arjun2000ananth/SAR_ADC_IHP/README.md

# 10-Bit SAR ADC — IHP SG13CMOS5L

A fully differential 10-bit successive-approximation-register (SAR) ADC designed in the **IHP SG13CMOS5L** process for the **Chipalooza Challenge**.

The repository contains the transistor-level analog design, SAR control logic, block-level and top-level layout, post-layout verification, and the integration into **Chipalooza slot 16**.

The ADC targets approximately **1 MS/s** operation and uses separate **3.3 V analog/high-voltage** and **1.2 V digital/low-voltage** supply domains.

ADC block and slot-level sign-off have passed. Result plots are available in [`docs/`](docs/).

---

## Team

| Name | Role |
|---|---|
| Arjun Ananth | Lead Designer - Design & Layout |
| Man Yu | Verification |

---

## Overview

The ADC uses a fully differential charge-redistribution SAR architecture.

Main blocks:

- Differential input sampling network
- Fully differential 10-bit capacitive DAC
- Strong-arm dynamic comparator with latch
- 1.2 V ↔ 3.3 V level shifters
- SAR finite-state machine
- Digital conversion outputs and status signals

Block diagram:

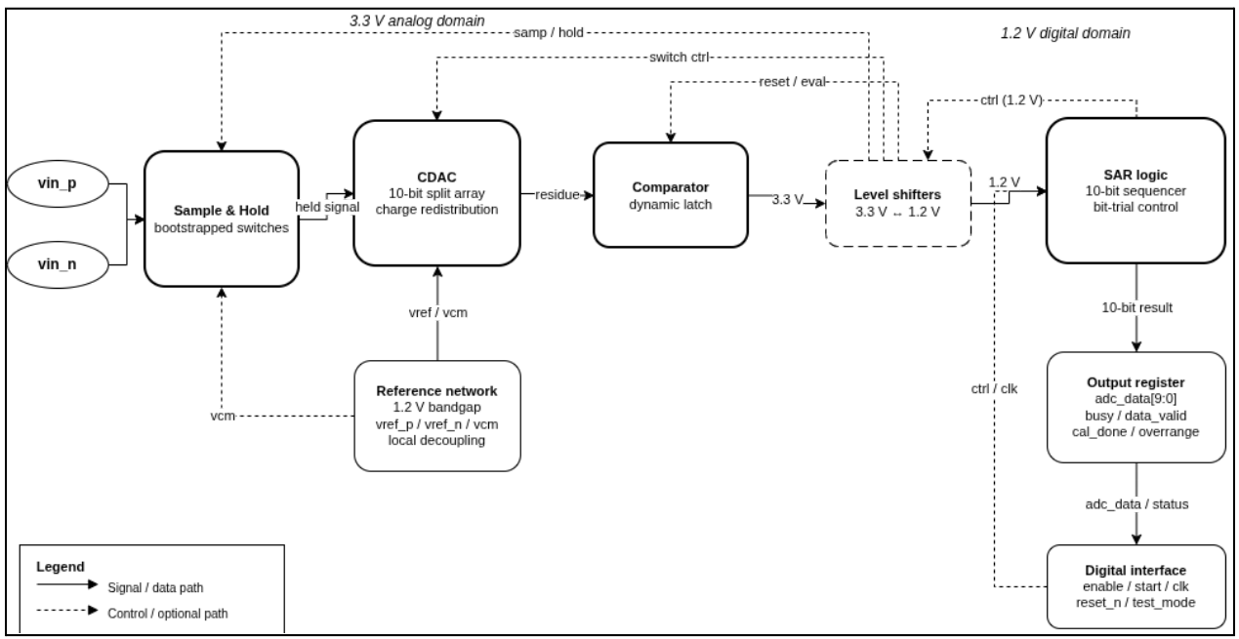
[picture p1: docs/Block_Diagram.png]
Block Diagram


---

## Architecture

The ADC consists of the following main blocks:

### Sampling Network

The differential input is sampled onto the CDAC before the SAR conversion begins.

### Capacitive DAC

A fully differential 10-bit capacitive DAC performs the successive-approximation charge redistribution. The CDAC uses a common-mode based differential switching scheme and is implemented using SG13CMOS5L MOM capacitors.

### Comparator

A strong-arm dynamic comparator performs the bit decisions during conversion.

### Level Shifters

The analog circuitry operates primarily from the 3.3 V domain while the SAR controller operates at 1.2 V. Level shifters provide the required voltage-domain crossings between the digital controller and the analog switching circuitry.

### SAR Controller

The SAR controller is implemented as a synthesized FSM operating in the 1.2 V domain.

It controls:

- Sampling
- Comparator timing
- CDAC bit decisions
- Conversion sequencing
- `busy`
- `valid`
- Final 10-bit output code

---

## Conversion Sequence

A conversion proceeds as follows:

1. The differential input is sampled onto the CDAC.
2. The sampling switches open.
3. The SAR controller applies the MSB trial decision.
4. The comparator resolves the differential DAC residue.
5. The decision is stored.
6. Steps 3–5 repeat for the remaining bits.
7. The final 10-bit result is presented on `C[9:0]`.
8. `valid` is asserted when the result is available.

`busy` indicates that a conversion is currently in progress.

At a 60 MHz conversion clock, the controller completes one conversion every 60 cycles (1 MS/s) in the functional simulation.

---

## Supply Domains

| Domain | Nominal Voltage | Usage |
|---|---:|---|
| `vddh` | 3.3 V | Analog / hv circuitry |
| `vddl` | 1.2 V | SAR FSM and lv digital circuitry |
| `vss` | 0 V | Common ground |

The nominal CDAC reference (`vrefp`) is 3.3 V, with `vcm` at 1.65 V. Both references are routed through shared analog buses in the harness.

---

## SAR ADC Interface

The reusable `sar_10_bit` ADC macro has the following interface.

### Analog and Supply Pins

| Signal | Direction | Description |
|---|---|---|
| `ainp` | Input | Positive differential analog input |
| `ainn` | Input | Negative differential analog input |
| `vrefp` | Input | CDAC reference voltage |
| `vcm` | Input | Common-mode voltage |
| `Voutn` | Output | Comparator/debug analog output |
| `vddh` | Supply | 3.3 V supply |
| `vddl` | Supply | 1.2 V supply |
| `vss` | Supply | Ground |

### Digital Control Pins

| Signal | Direction | Description |
|---|---|---|
| `CLK` | Input | SAR conversion clock |
| `START` | Input | Starts a conversion |
| `RSTN` | Input | Active-low reset |

### Digital Outputs

| Signal | Direction | Description |
|---|---|---|
| `C0`–`C9` | Output | 10-bit conversion result |
| `busy` | Output | Conversion in progress |
| `valid` | Output | Conversion result valid |

---

# Chipalooza Integration

This project is assigned to **slot 16** of the IHP SG13CMOS5L Chipalooza test chip. The reusable ADC and the Chipalooza implementation are kept separate.

The harness integration expects its slot GDS at:

```text
final/gds/slot_16.gds
```

The `sar_10_bit` cell remains the reusable ADC macro and can be integrated independently into other designs.

---

## Slot-16 Signal Mapping

### Analog Inputs and References

| Chipalooza Signal | ADC Signal | Function |
|---|---|---|
| `s16_an[0]` | `ainp` | Positive differential input |
| `s16_an[1]` | `ainn` | Negative differential input |
| `analog_bus0` | `vrefp` | ADC reference voltage |
| `analog_bus1` | `vcm` | ADC common-mode voltage |

### Supplies

| Chipalooza Signal | ADC Signal |
|---|---|
| `vdd_3v3` | `vddh` |
| `vdd_1v2` | `vddl` |
| Ground network | `vss` |

### Control

| Chipalooza Signal | ADC Signal |
|---|---|
| `clk` | `CLK` |
| `dig_in[0]` | `START` |
| `dig_in[1]` | `RSTN` |

### Digital Outputs

| ADC Signal | Chipalooza Signal |
|---|---|
| `C0` | `dig_out[0]` |
| `C1` | `dig_out[1]` |
| `C2` | `dig_out[2]` |
| `C3` | `dig_out[3]` |
| `C4` | `dig_out[4]` |
| `C5` | `dig_out[5]` |
| `C6` | `dig_out[6]` |
| `C7` | `dig_out[7]` |
| `C8` | `dig_out[8]` |
| `C9` | `dig_out[9]` |
| `busy` | `dig_out[10]` |
| `valid` | `dig_out[11]` |

The harness routes START and RSTN through a digital input latch. A sustained START level produces repeated conversions; a short single-shot START pulse can be supplied through an external GPIO route or an appropriately configured sequencer.

---

# Layout

The reusable top-level ADC GDS is located at:

```text
circuit_files/layout/top/sar_10_bit_top.gds
```

The pre-fill version is retained at:

```text
circuit_files/layout/top_prefill/sar_10_bit_top_prefill.gds
```

Individual block layouts are available under:

```text
circuit_files/layout/
```

Layout views and characterization result plots are available in [`docs/`](docs/).

---

# SAR FSM

The SAR controller RTL is located at:

```text
circuit_files/src/sar_fsm/sar_fsm.v
```

---

# Target Performance

| Parameter | Target | Status |
|---|---:|---|
| Resolution | 10 bits | 10 bits |
| Architecture | Fully differential SAR | Fully differential SAR |
| Sampling rate | 1 MS/s | 1 MS/s in harness functional simulation at 60 MHz |
| Analog supply | 3.3 V | 3.3 V nominal |
| Digital supply | 1.2 V | 1.2 V nominal |
| DNL | Within ±1 LSB | Peak absolute DNL 0.199 LSB |
| INL | Within ±1 LSB | Peak absolute INL 0.139 LSB |
| Missing codes | None | None |
| Input type | Differential | Differential |
| Digital result | 10-bit parallel code | `C[9:0]` |
| Status outputs | `busy`, `valid` | Verified in sim |

The latest characterization plots are in [`docs/`](docs/).

The analysis also reported a 57.2 mV peak VSS IR drop, a 1.75 Ω VCM switch-tap resistance, and a 4.23 fF differential top-plate parasitic-capacitance difference.

---

# Results and Figures

The plots, schematics, and layout views below are stored in [`docs/`](docs/) and displayed directly from those files. 

## ADC Layout

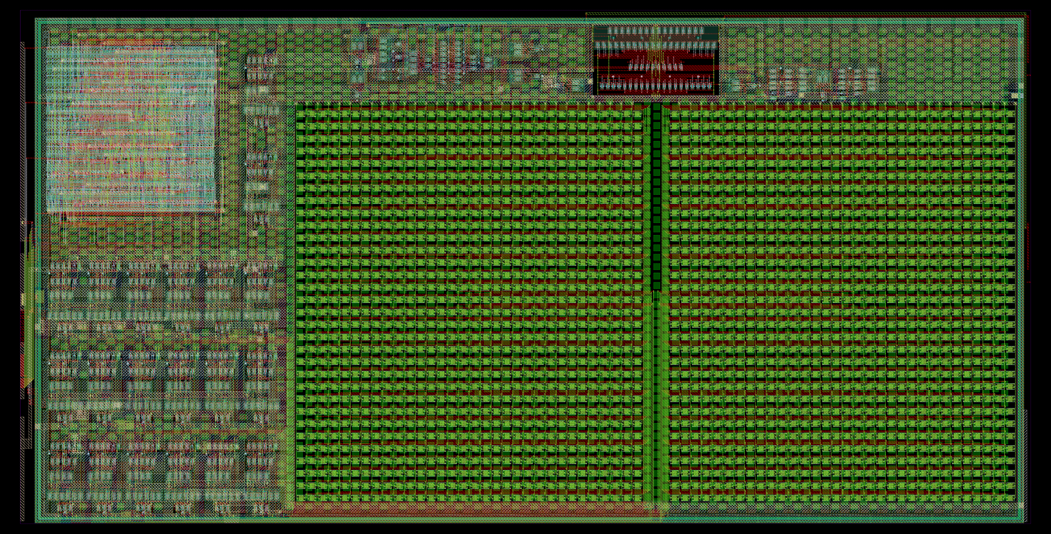
[picture p2: docs/layouts/sar_top_gds.png]
Complete SAR ADC GDS layout


*Top-level `sar_10_bit` layout.*

## Static Linearity and Transfer Characteristic

| | |
|:---:|:---:|
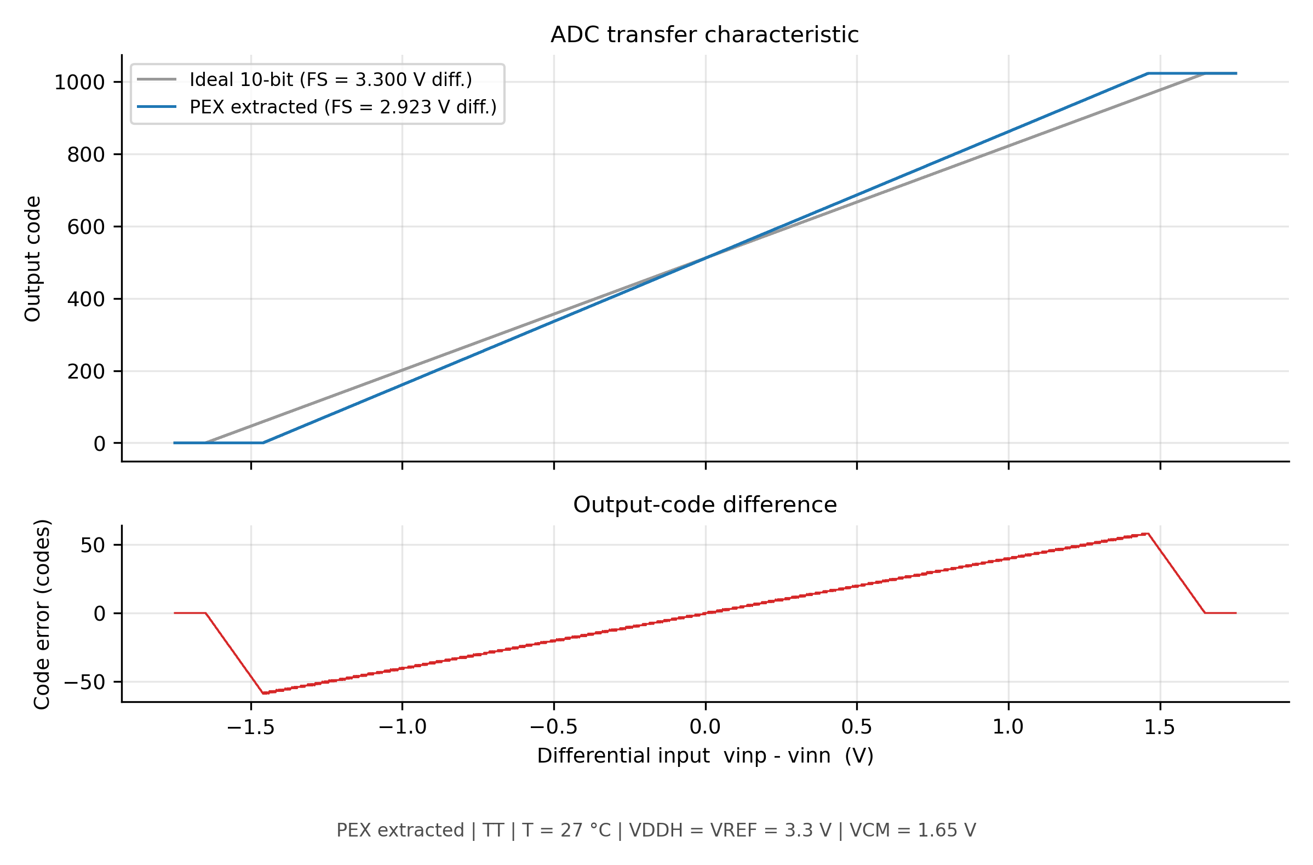
[picture p3: docs/transfer_characteristic.png]
ADC transfer characteristic
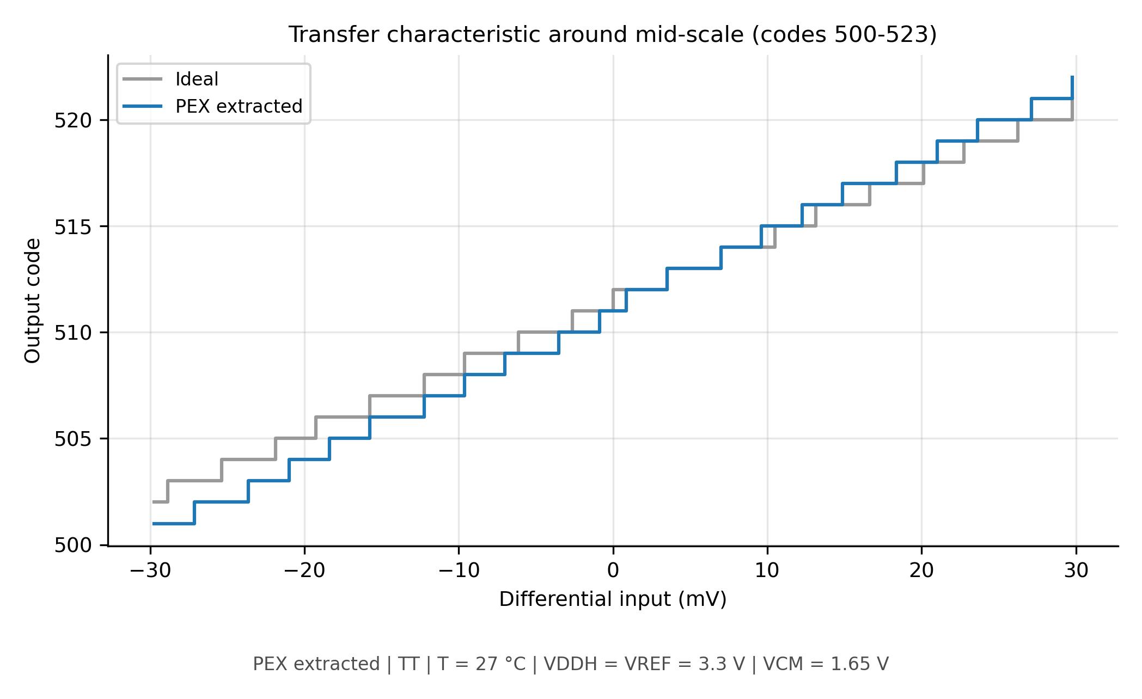
[picture p4: docs/transfer_midscale_zoom.png]
Transfer characteristic near midscale
| <br><sub>ADC transfer characteristic</sub> | <br><sub>Transfer characteristic near midscale</sub> |
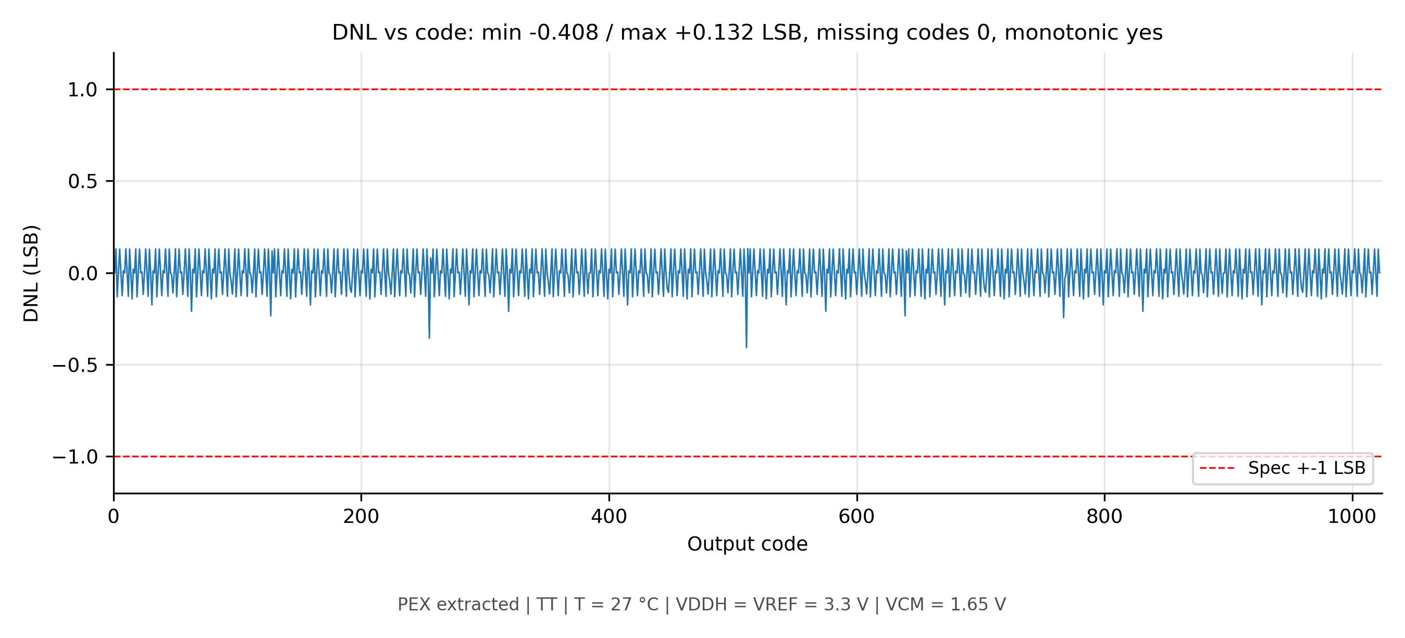
[picture p5: docs/dnl_vs_code.png]
DNL versus output code
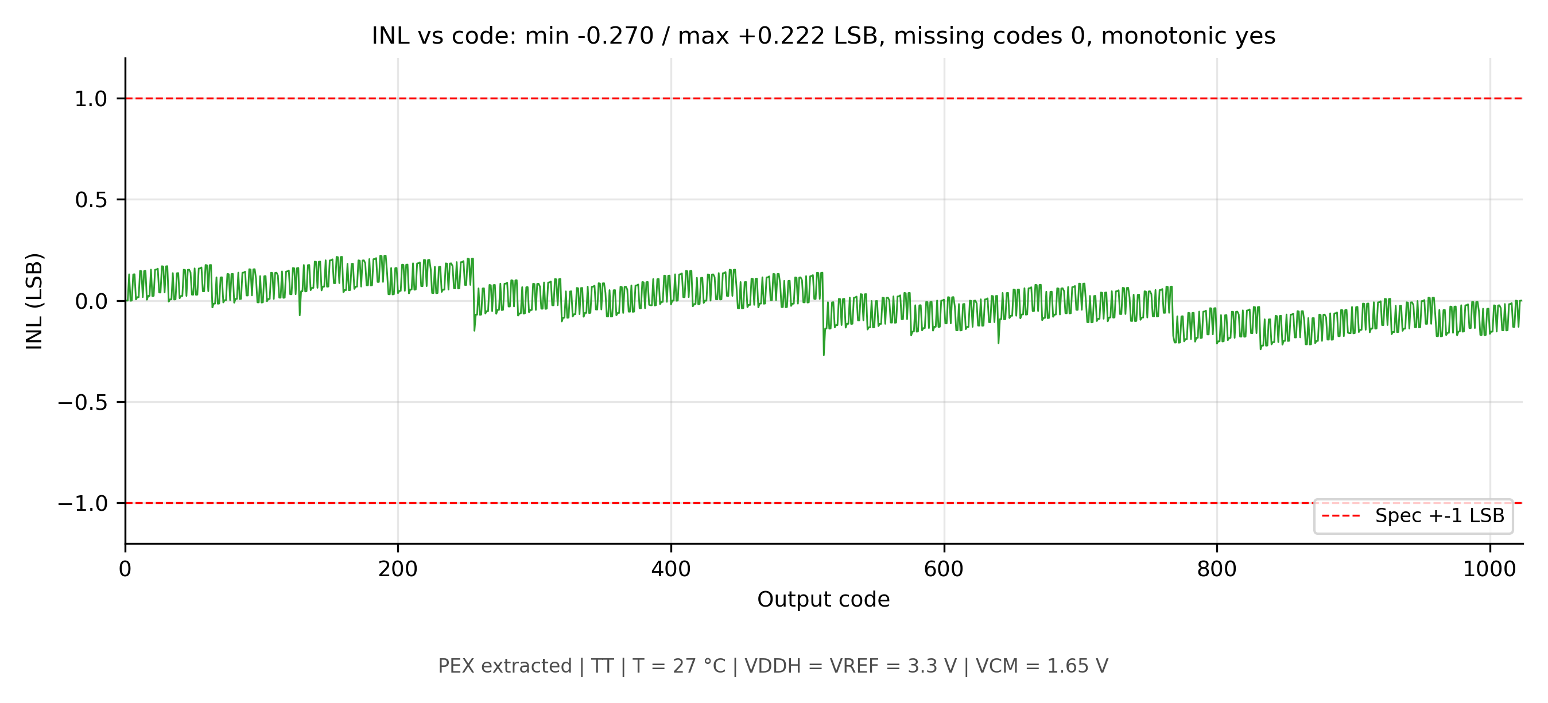
[picture p6: docs/inl_vs_code.png]
INL versus output code
| <br><sub>DNL versus output code</sub> | <br><sub>INL versus output code</sub> |
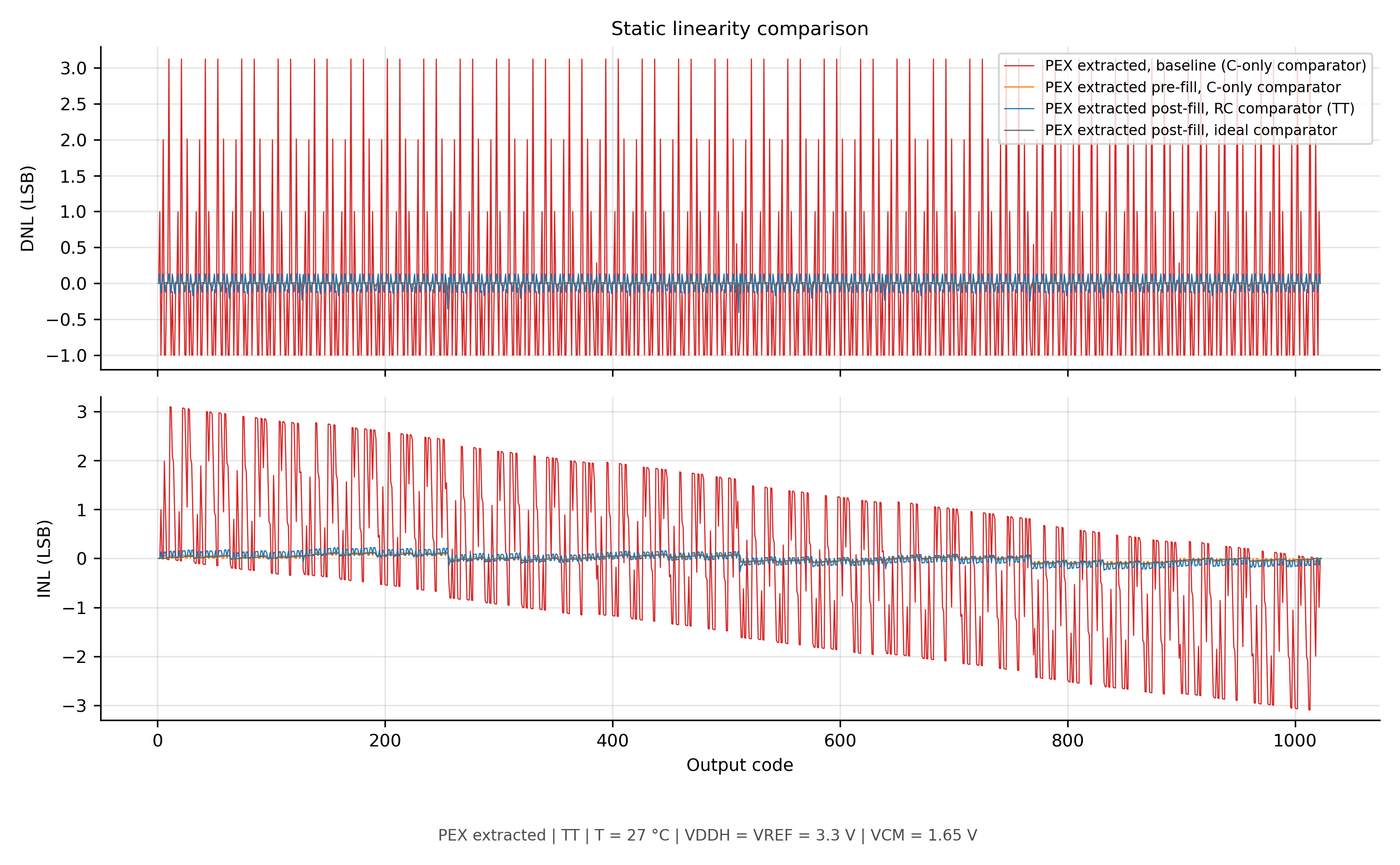
[picture p7: docs/dnl_inl_pex_comparison.png]
PEX linearity comparison
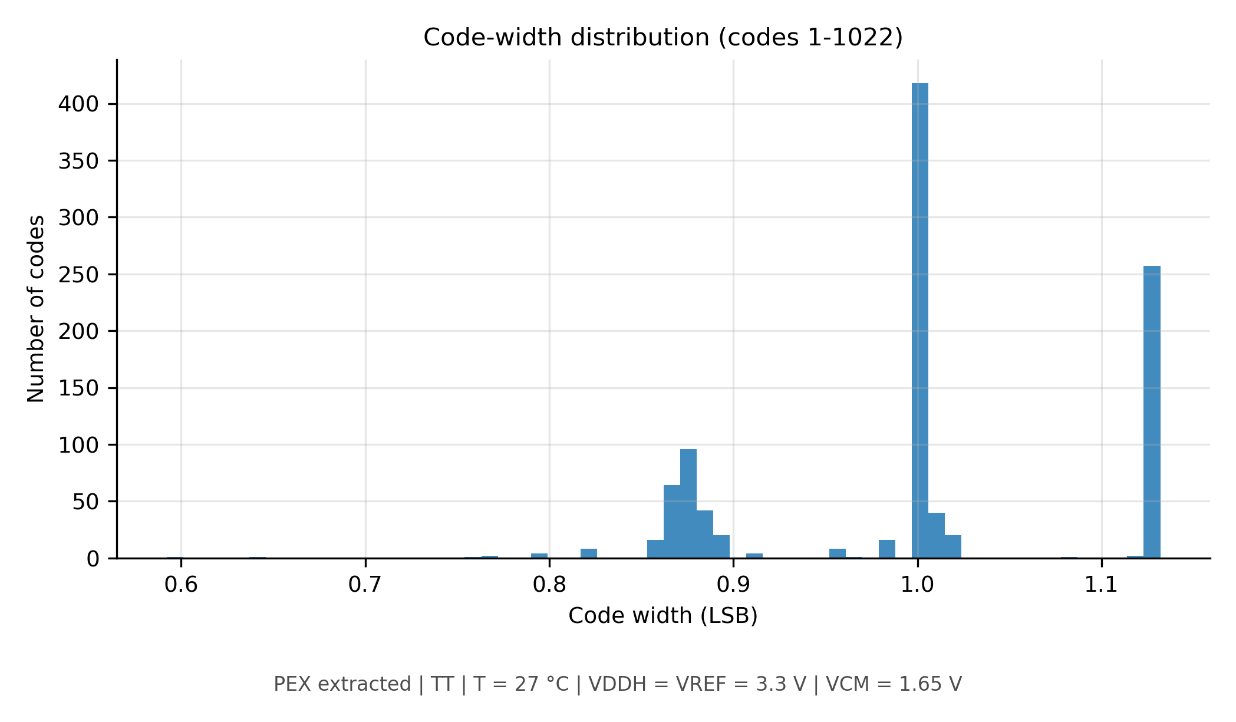
[picture p8: docs/code_width_histogram.png]
Code width histogram
| <br><sub>PEX linearity comparison</sub> | <br><sub>Code width histogram</sub> |

## Conversion Timing, Dynamic Performance and Power

| | |
|:---:|:---:|
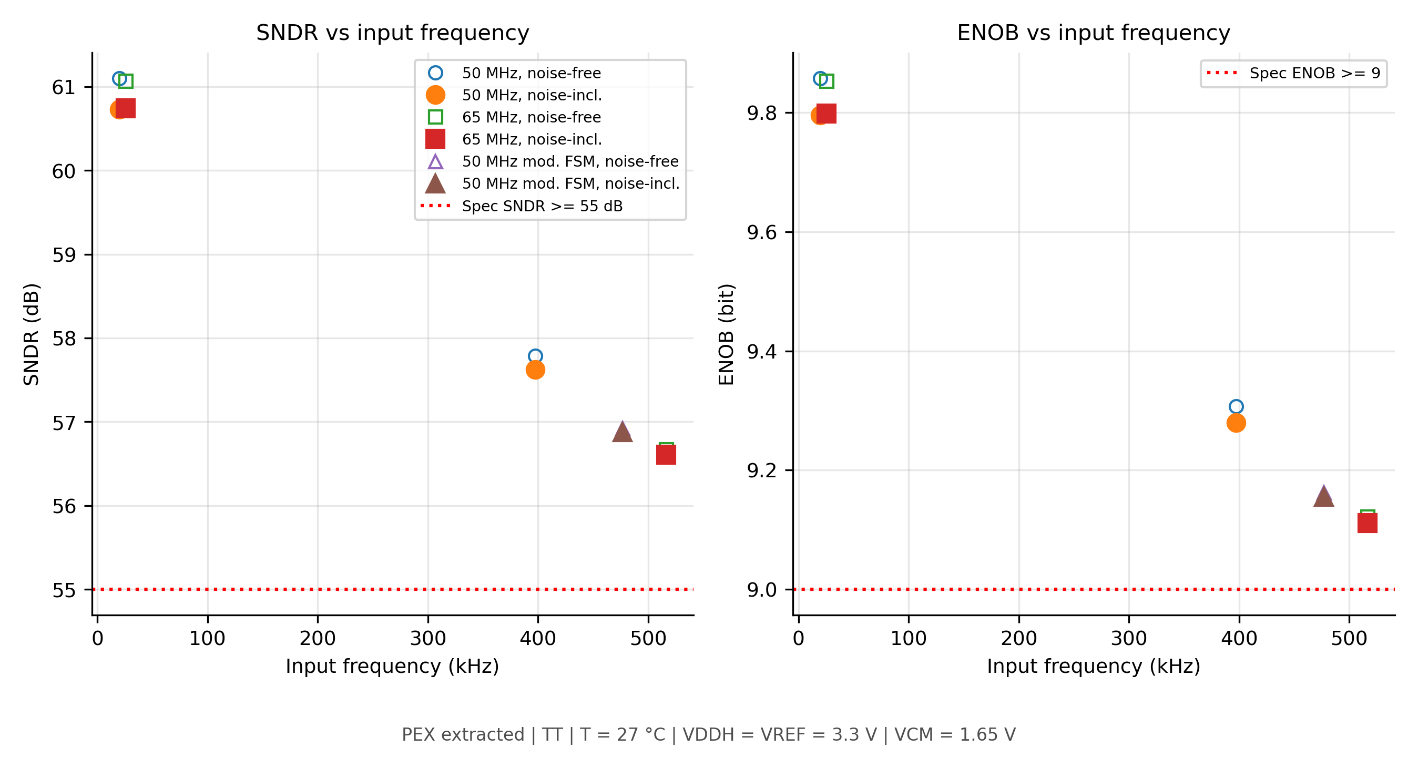
[picture p9: docs/sndr_enob_vs_fin.png]
SNDR and ENOB versus input frequency
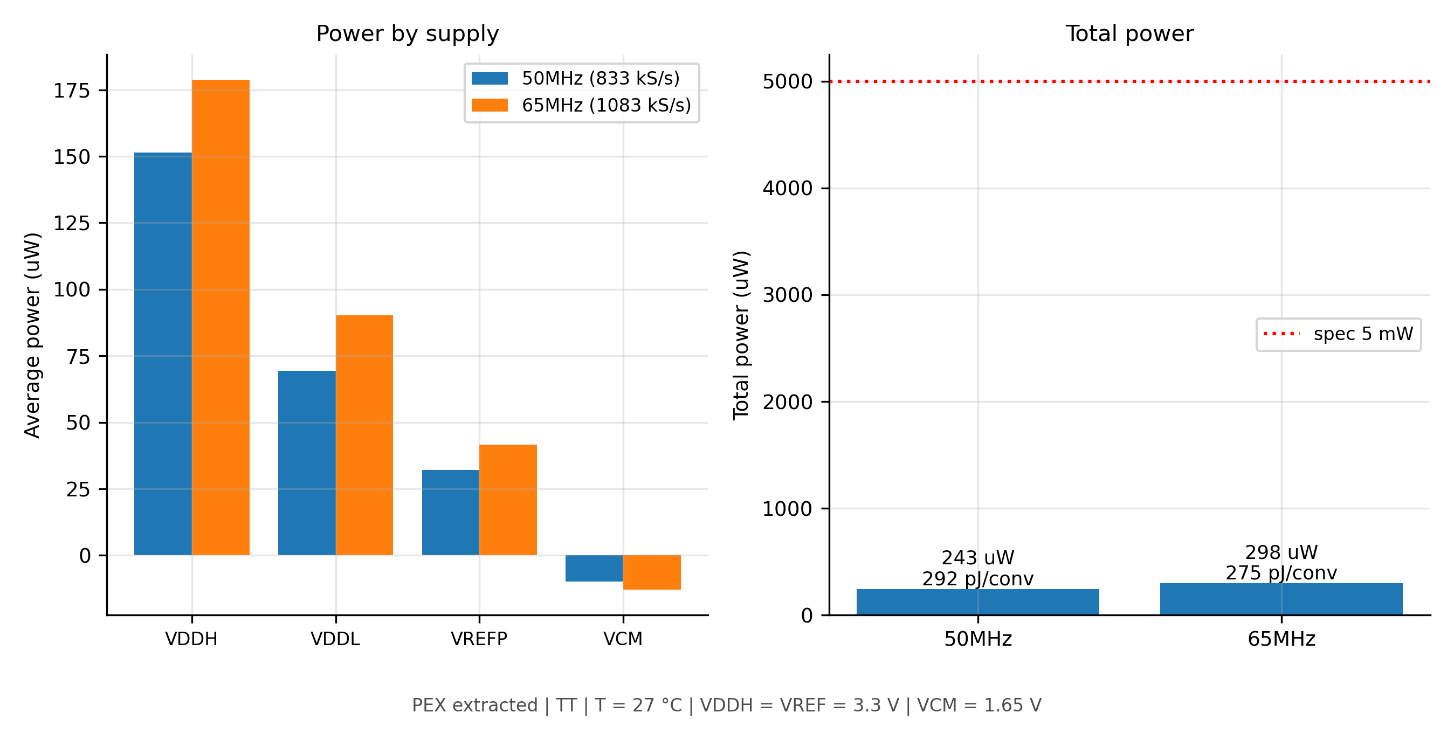
[picture p10: docs/power_50_vs_65MHz.png]
Power at 50 and 65 MHz
| <br><sub>SNDR and ENOB versus input frequency</sub> | <br><sub>Power at 50 and 65 MHz</sub> |
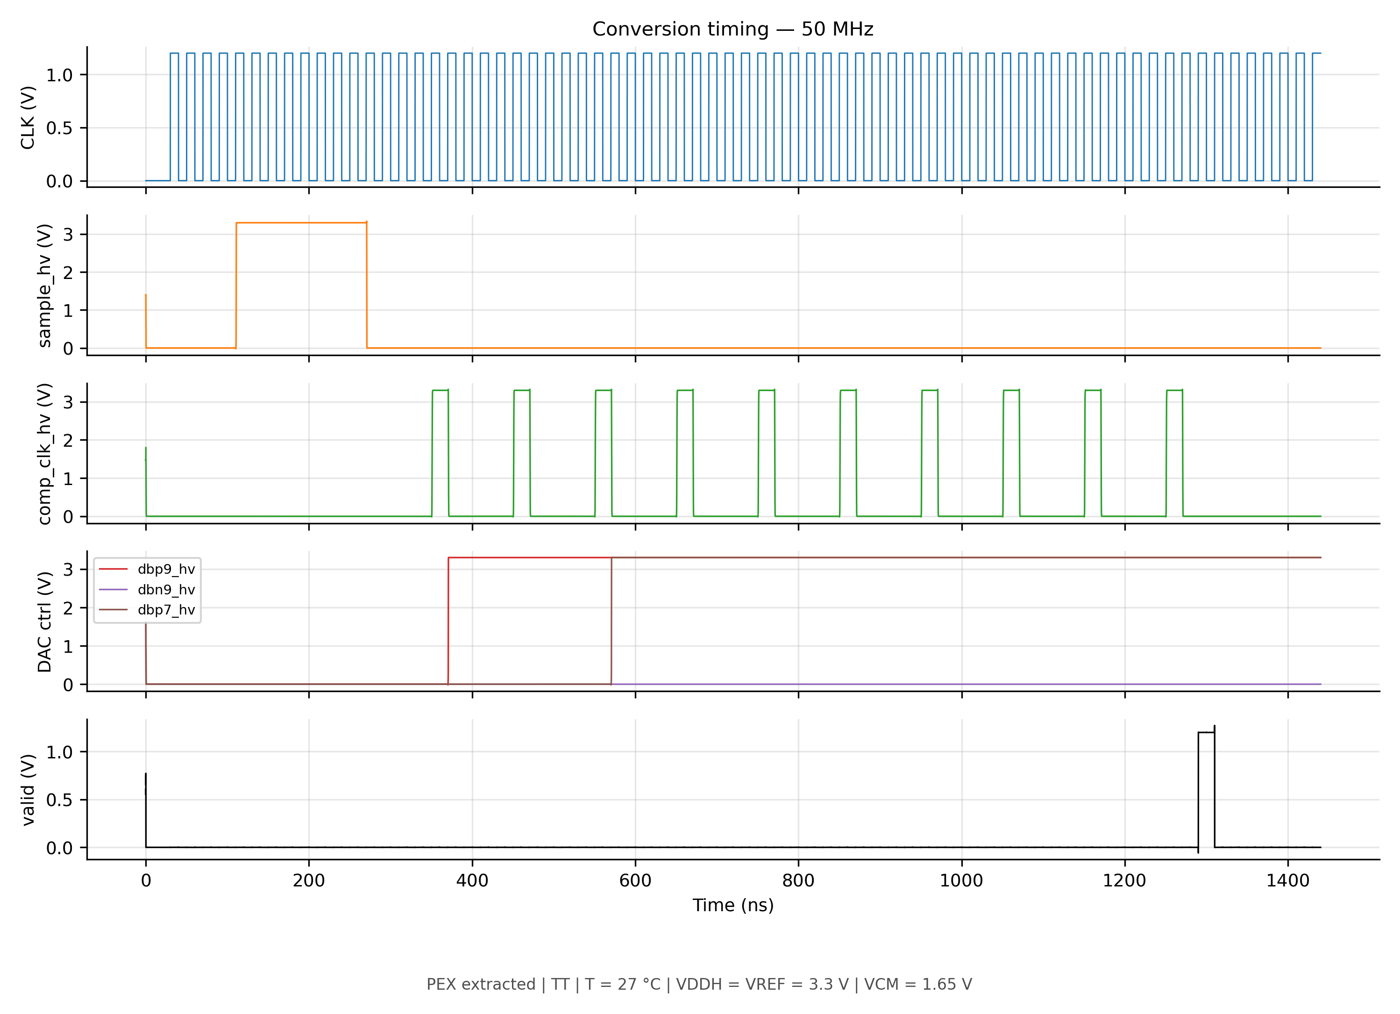
[picture p11: docs/conversion_timing_50MHz.png]
Conversion timing at 50 MHz
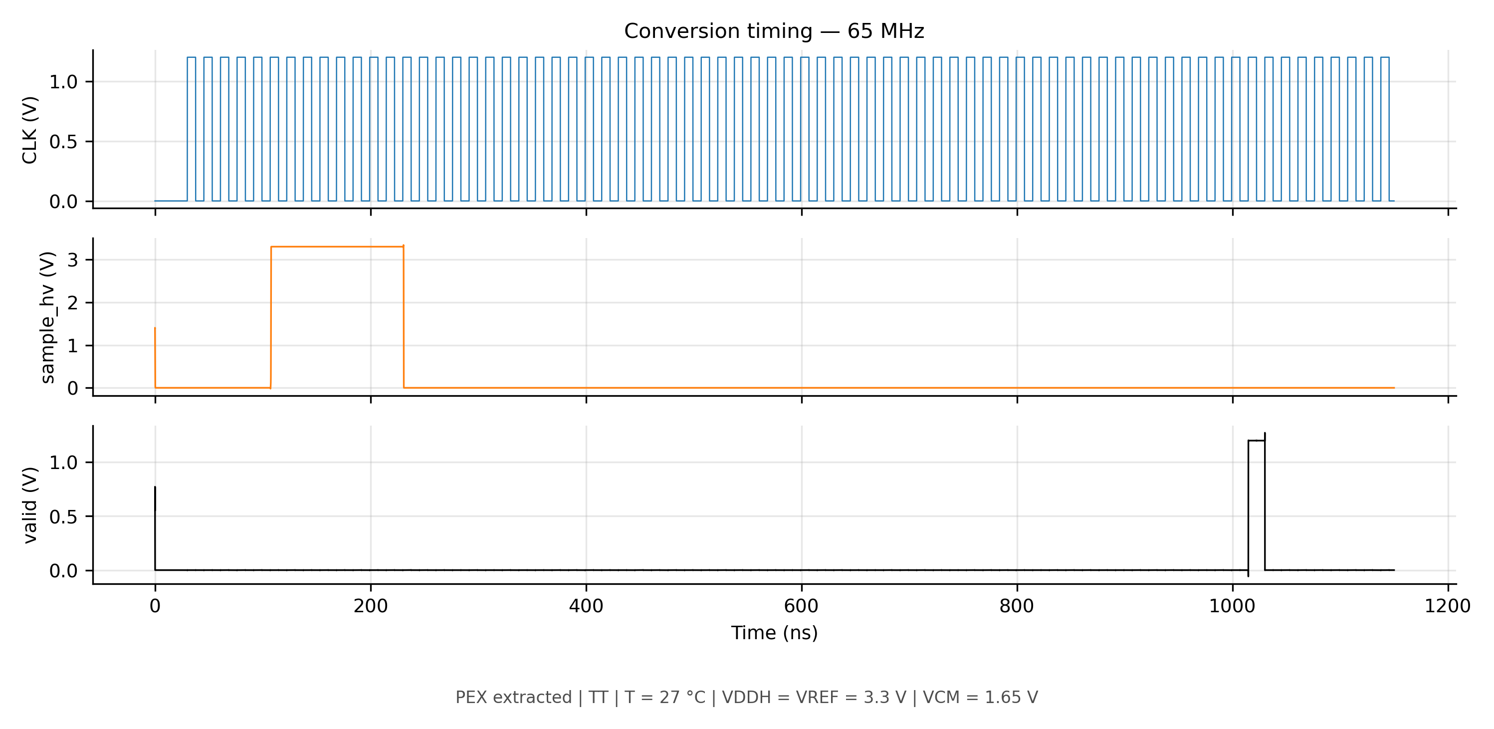
[picture p12: docs/conversion_timing_65MHz.png]
Conversion timing at 65 MHz
| <br><sub>Conversion timing at 50 MHz</sub> | <br><sub>Conversion timing at 65 MHz</sub> |
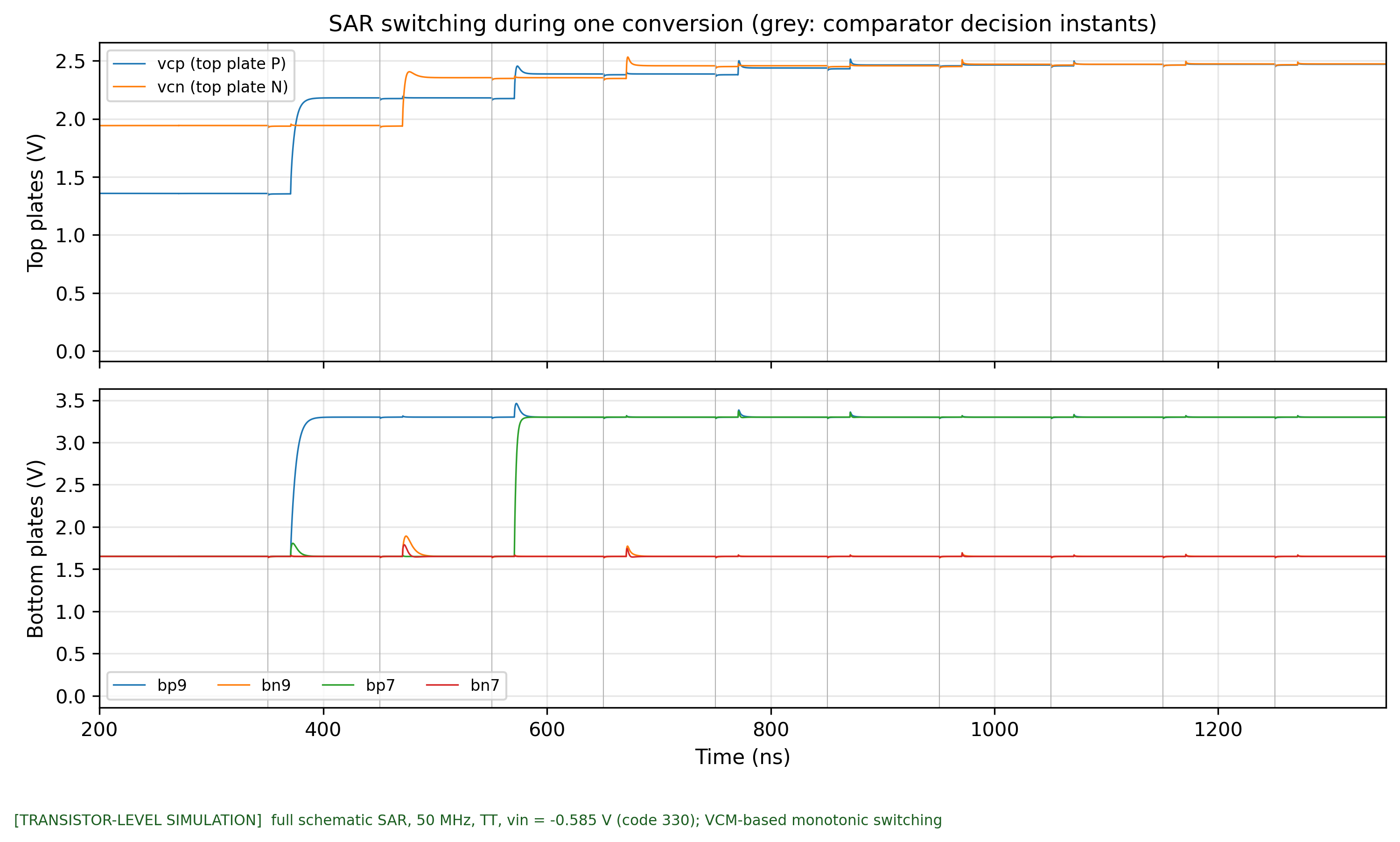
[picture p13: docs/sar_switching_waveforms.png]
SAR switching waveforms
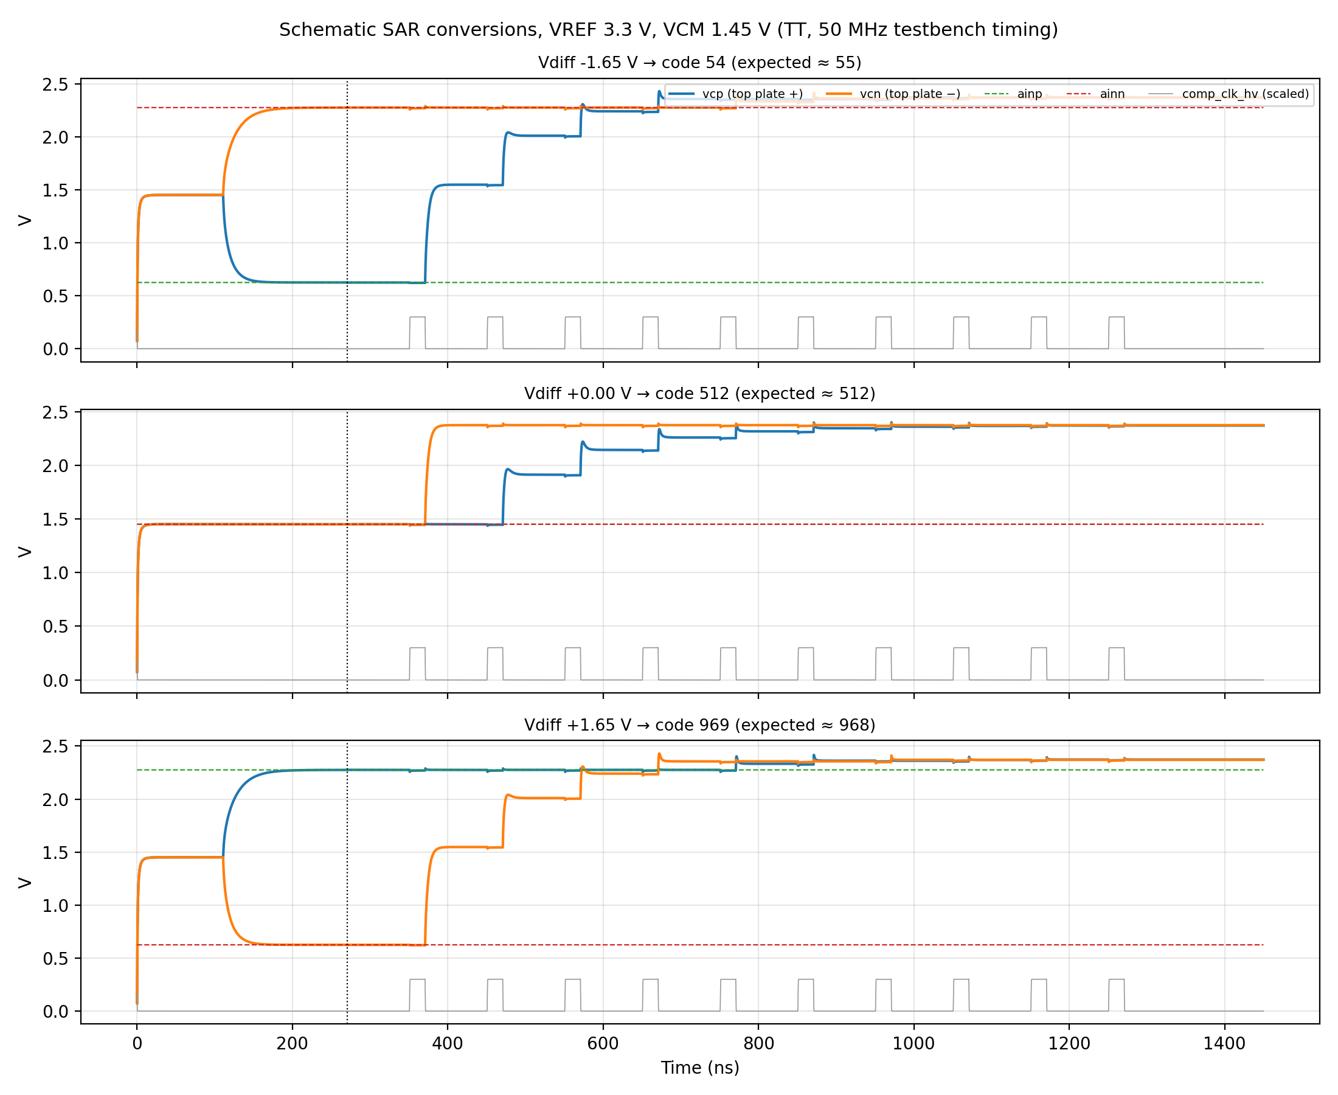
[picture p14: docs/smoke_vcm1.45_waveforms.png]
Transient smoke test with VCM at 1.45 V
| <br><sub>SAR switching waveforms</sub> | <br><sub>Transient smoke test with VCM at 1.45 V</sub> |

## CDAC Settling

| | |
|:---:|:---:|
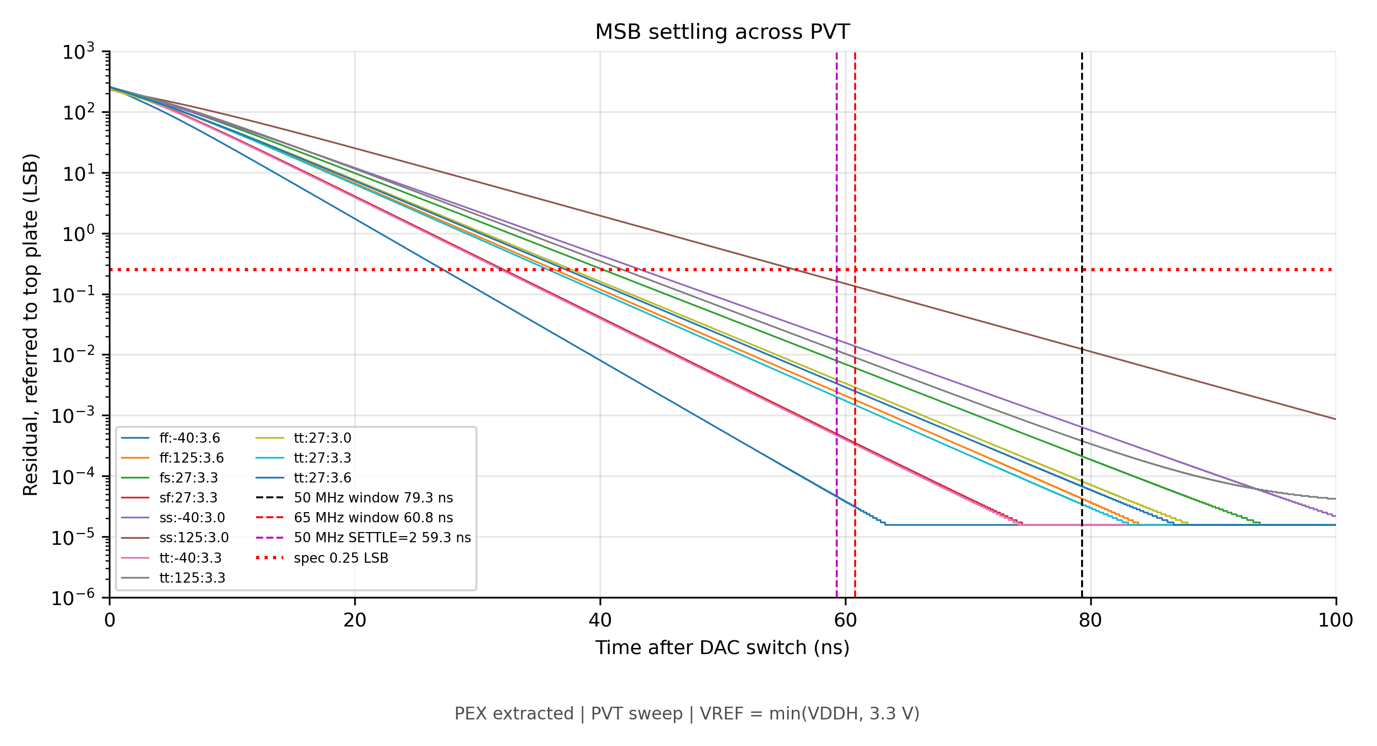
[picture p15: docs/cdac_settling/msb_settling_pvt.png]
MSB settling across PVT conditions
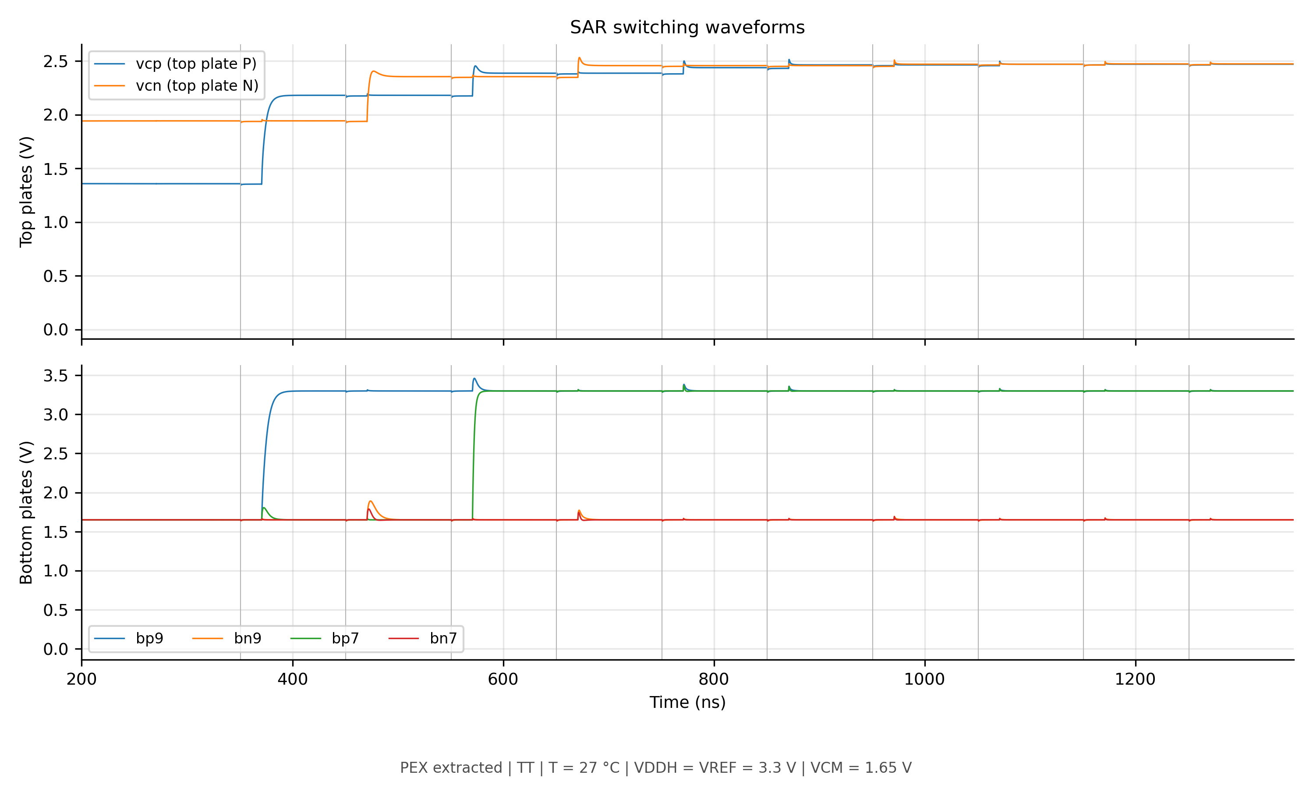
[picture p16: docs/cdac_settling/sar_switching_waveforms.png]
CDAC switching waveforms
| <br><sub>MSB settling across PVT conditions</sub> | <br><sub>CDAC switching waveforms</sub> |

## Comparator Characterization

| | |
|:---:|:---:|
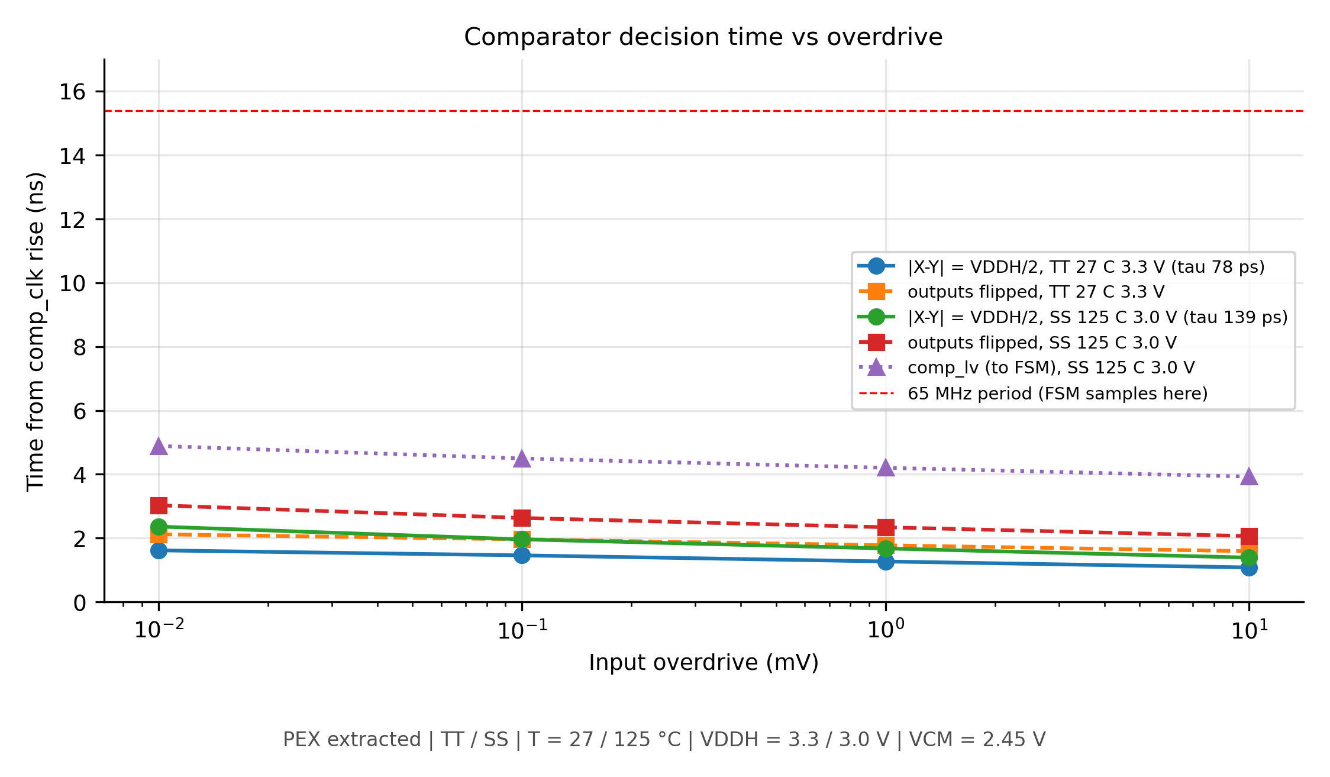
[picture p17: docs/comparator/decision_time_vs_overdrive.png]
Comparator decision time versus overdrive
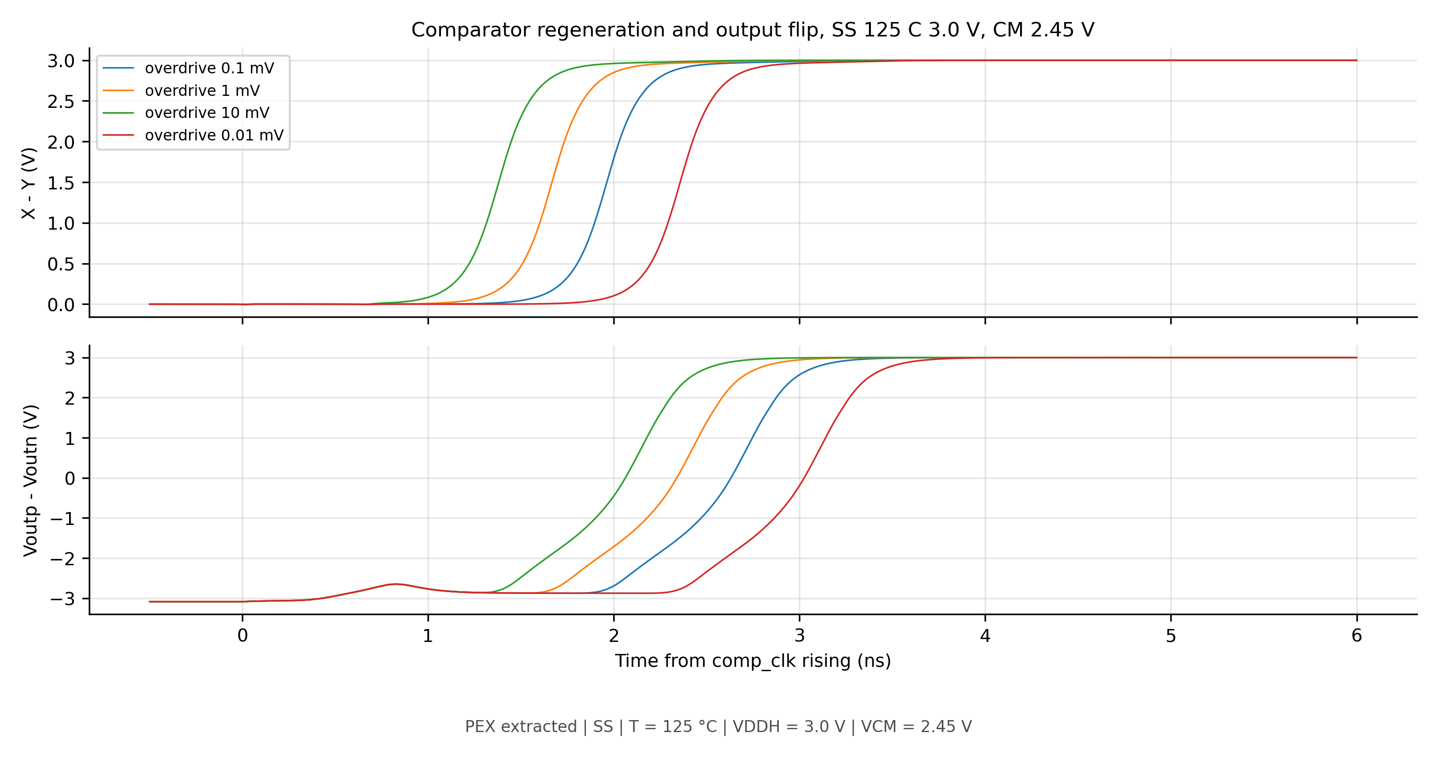
[picture p18: docs/comparator/decision_waveforms_ss_125_3.png]
Comparator waveforms, SS at 125 C
| <br><sub>Comparator decision time versus overdrive</sub> | <br><sub>Comparator waveforms, SS at 125 C</sub> |
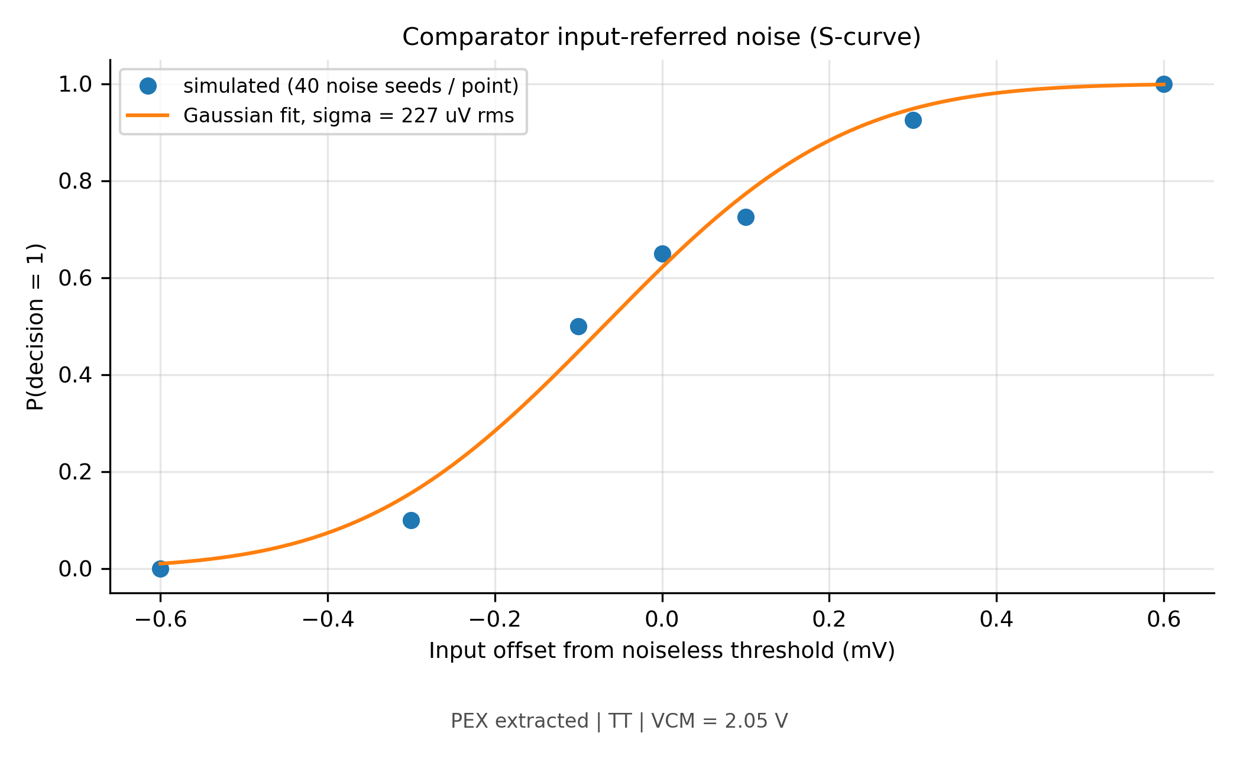
[picture p19: docs/comparator/noise_scurve.png]
Comparator noise S-curve
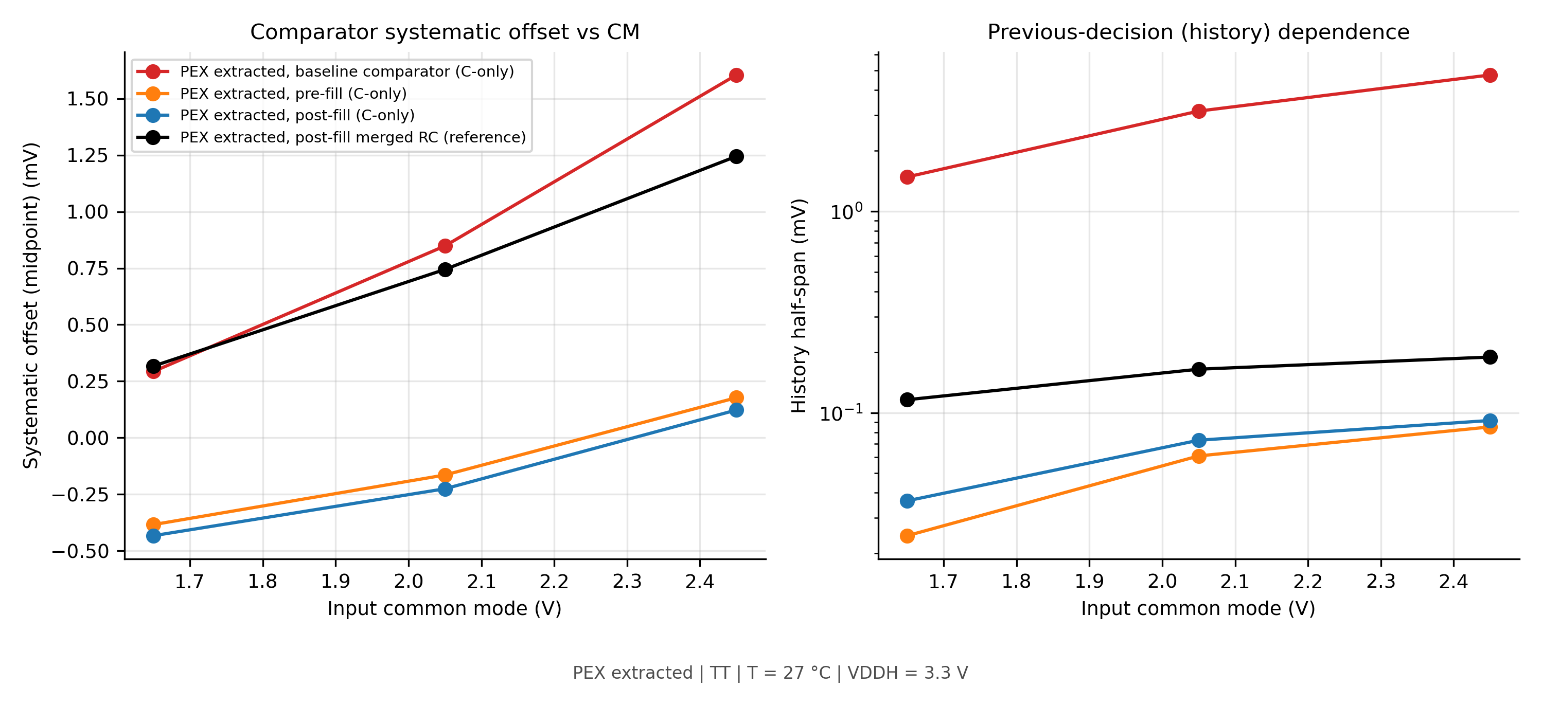
[picture p20: docs/comparator/offset_history_vs_cm.png]
Comparator offset history versus common-mode
| <br><sub>Comparator noise S-curve</sub> | <br><sub>Comparator offset history versus common-mode</sub> |

## PVT and Monte Carlo Analysis

| | |
|:---:|:---:|
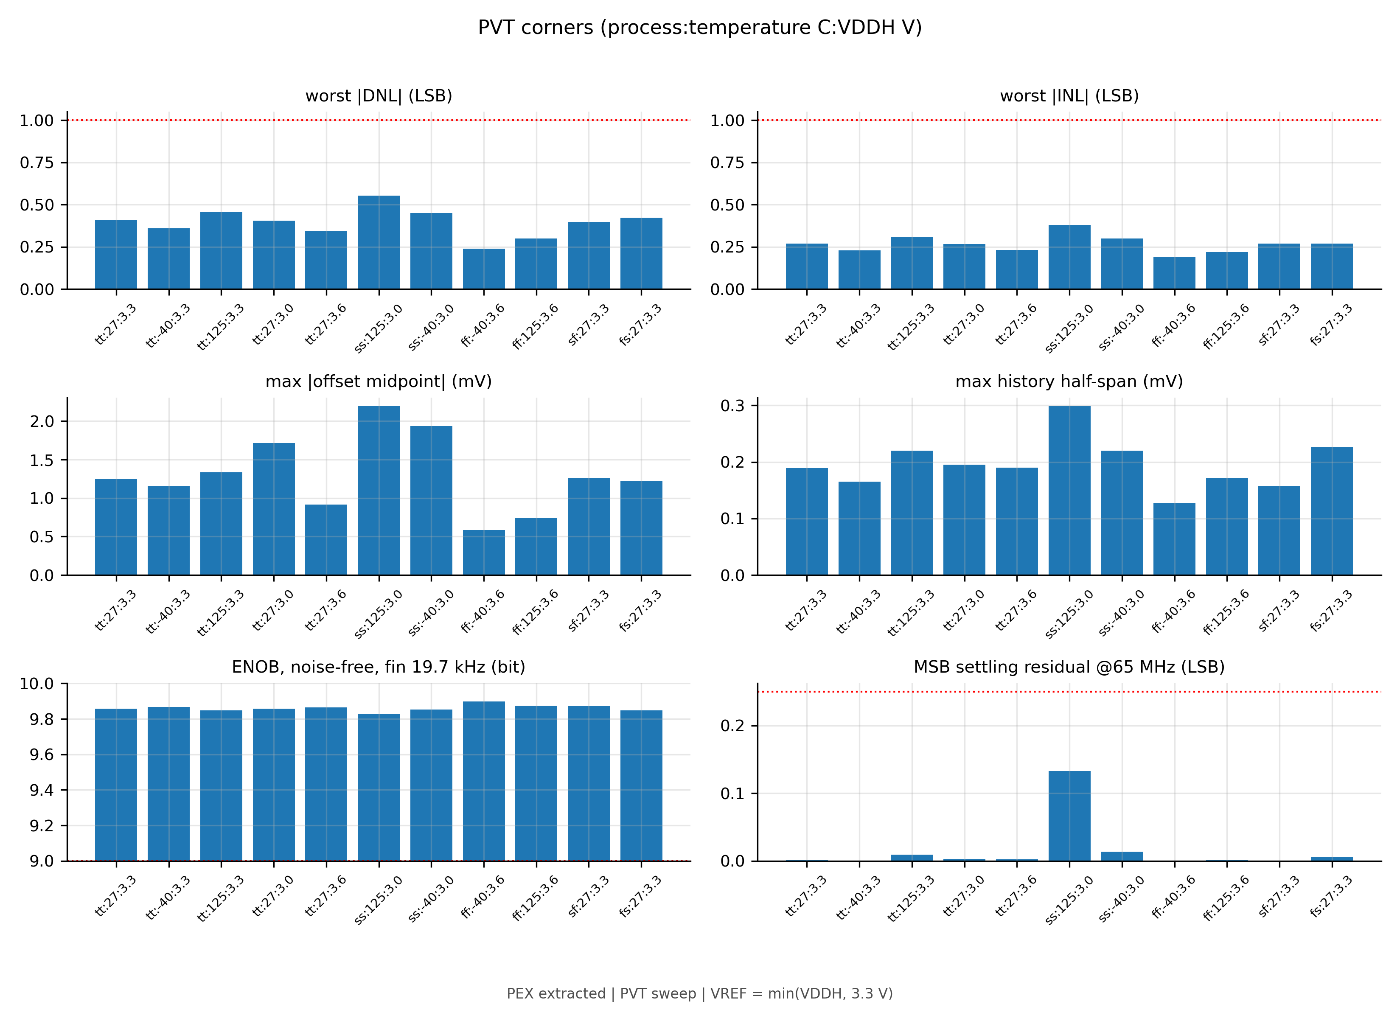
[picture p21: docs/corner/pvt_summary.png]
PVT corner summary
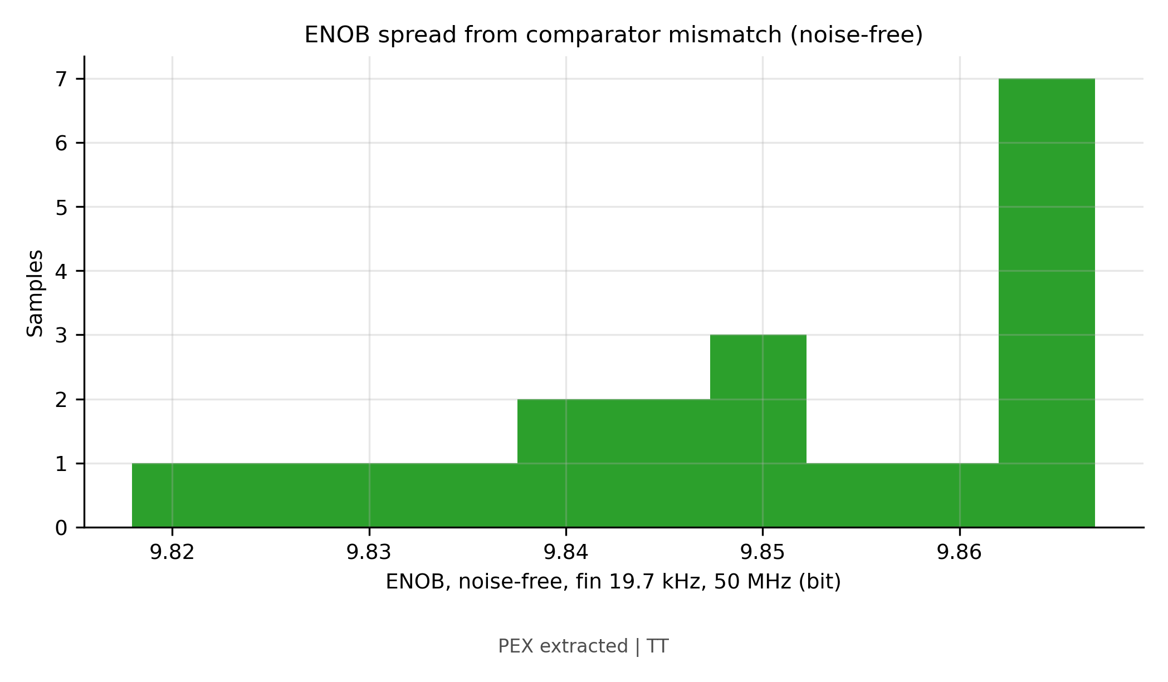
[picture p22: docs/montecarlo/enob_distribution.png]
Monte Carlo ENOB distribution
| <br><sub>PVT corner summary</sub> | <br><sub>Monte Carlo ENOB distribution</sub> |
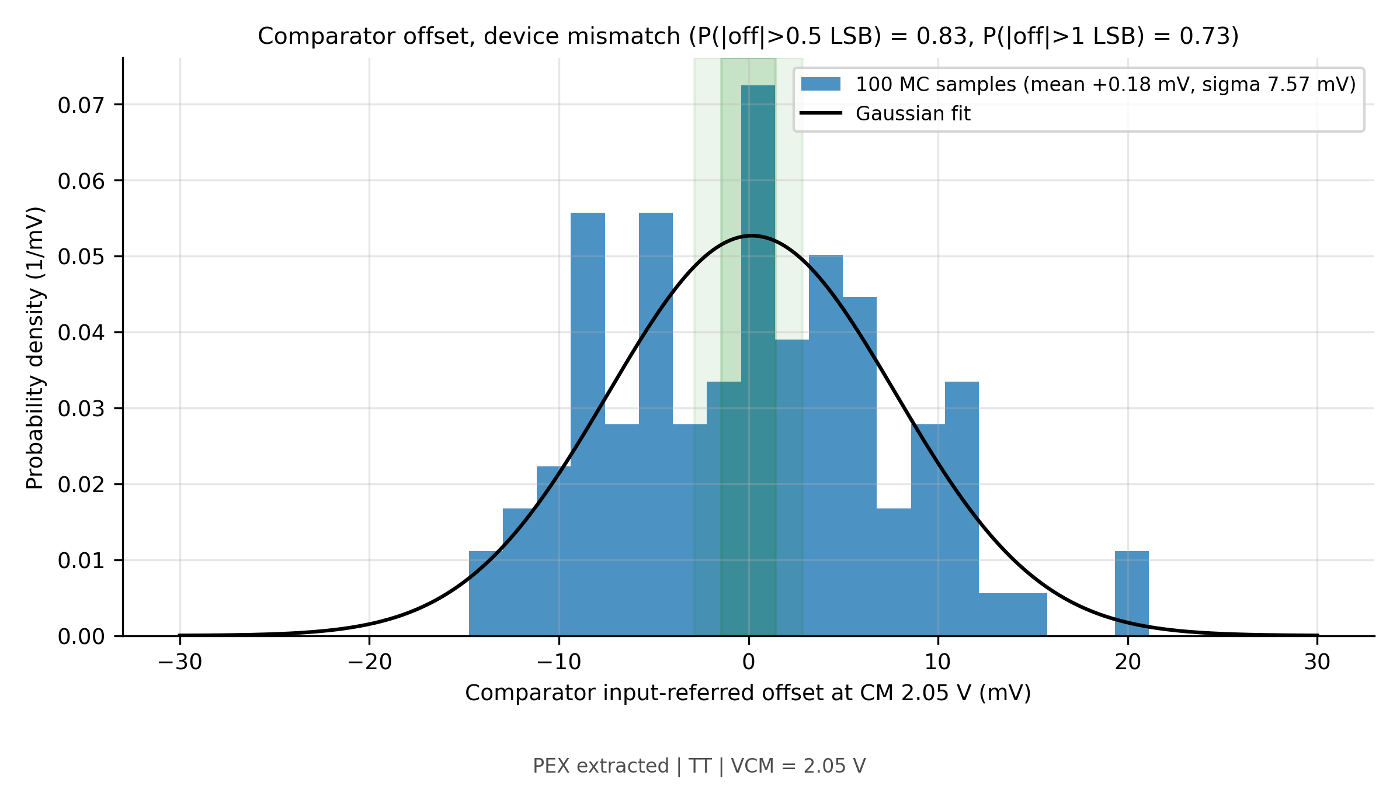
[picture p23: docs/montecarlo/offset_histogram.png]
Monte Carlo comparator offset histogram
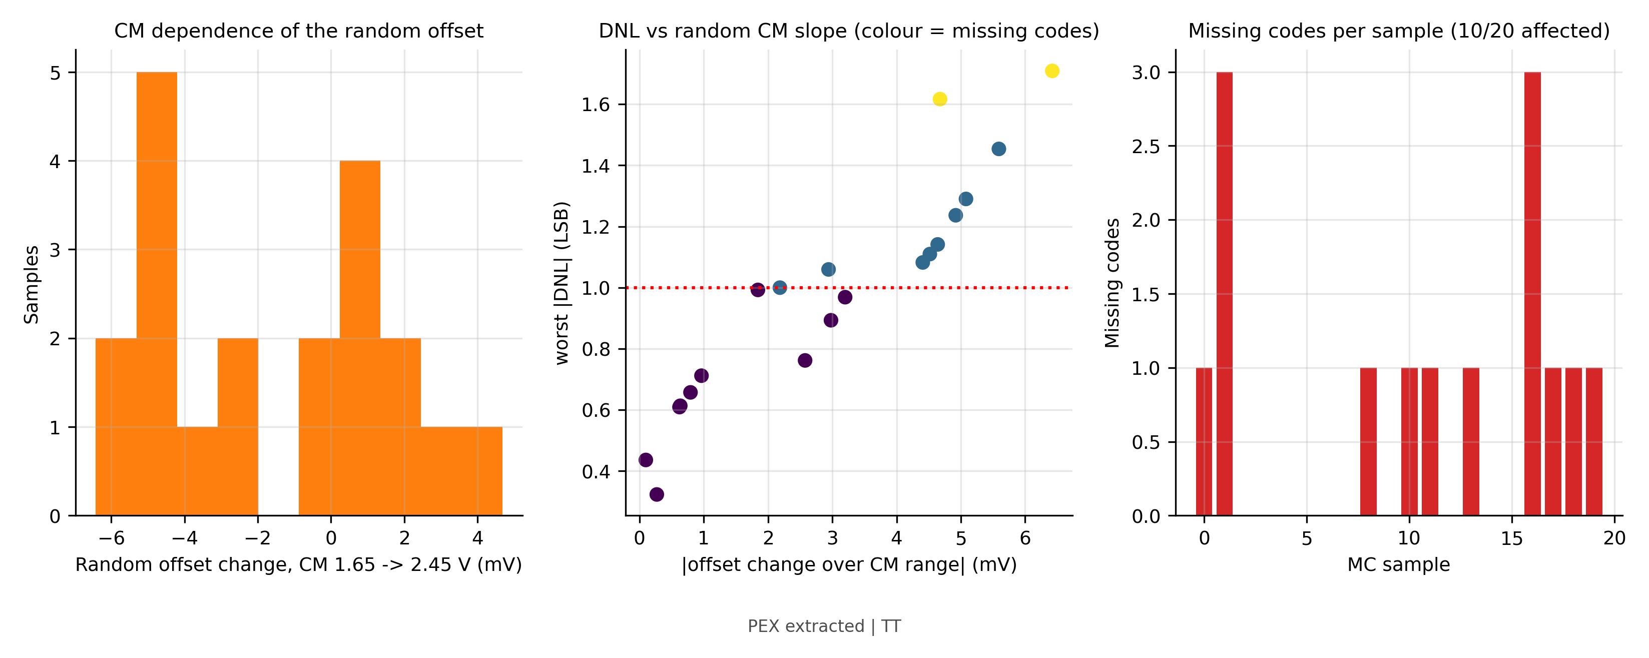
[picture p24: docs/montecarlo/statistical_linearity.png]
Statistical linearity
| <br><sub>Monte Carlo comparator offset histogram</sub> | <br><sub>Statistical linearity</sub> |

## Block Layouts

| | |
|:---:|:---:|
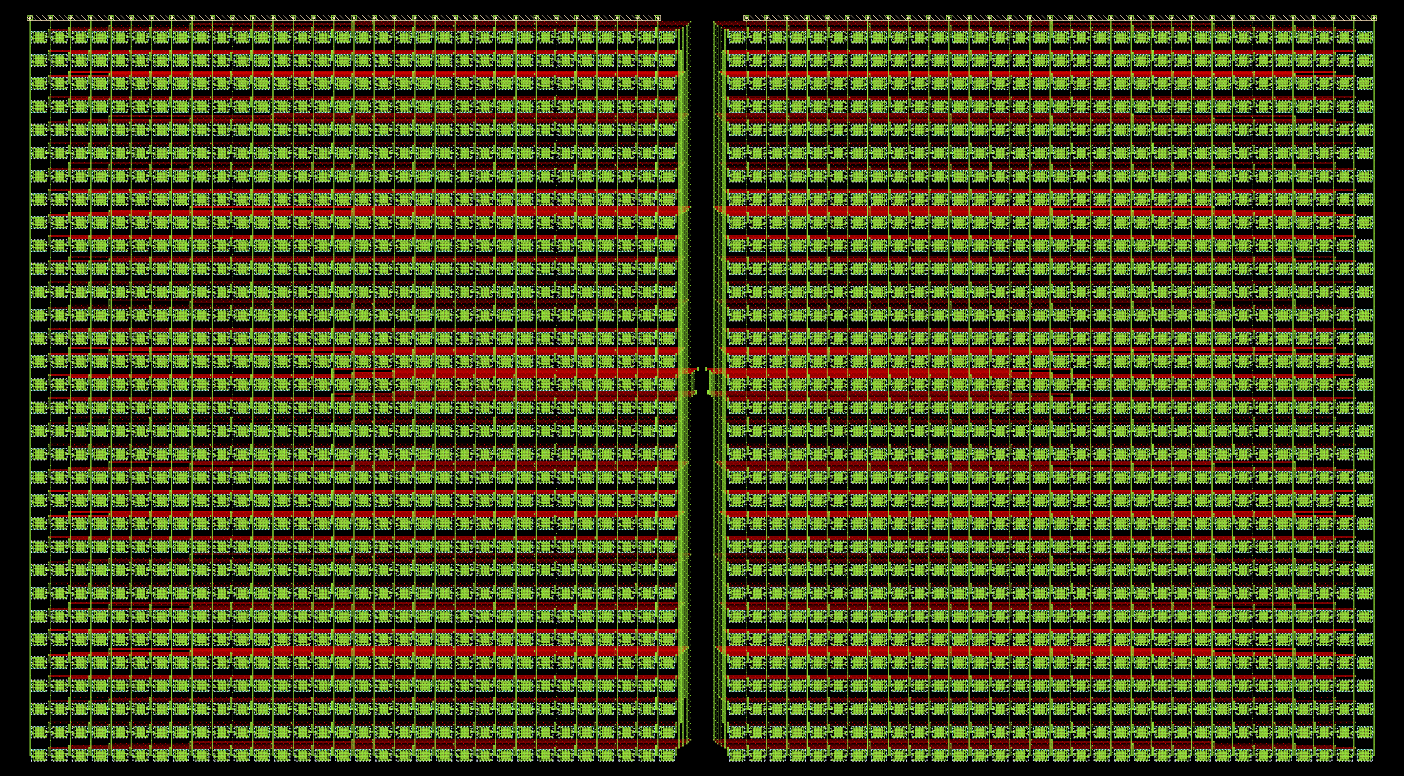
[picture p25: docs/layouts/cdac_array_10b_diff.png]
Differential CDAC array
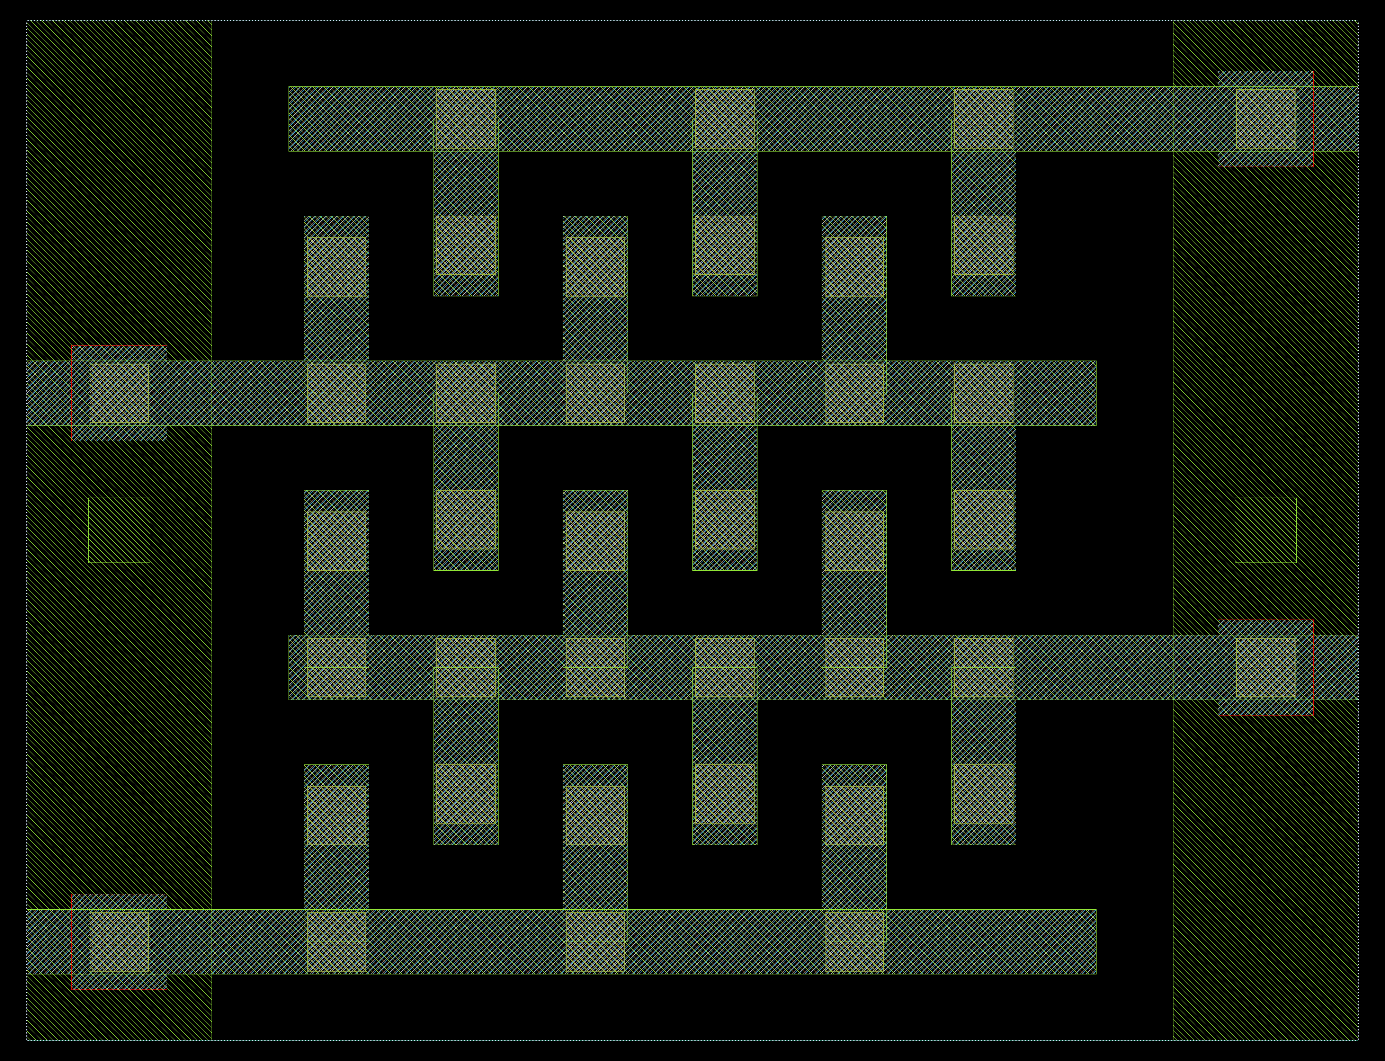
[picture p26: docs/layouts/cdac_unit.png]
CDAC unit capacitor
| <br><sub>Differential CDAC array</sub> | <br><sub>CDAC unit capacitor</sub> |
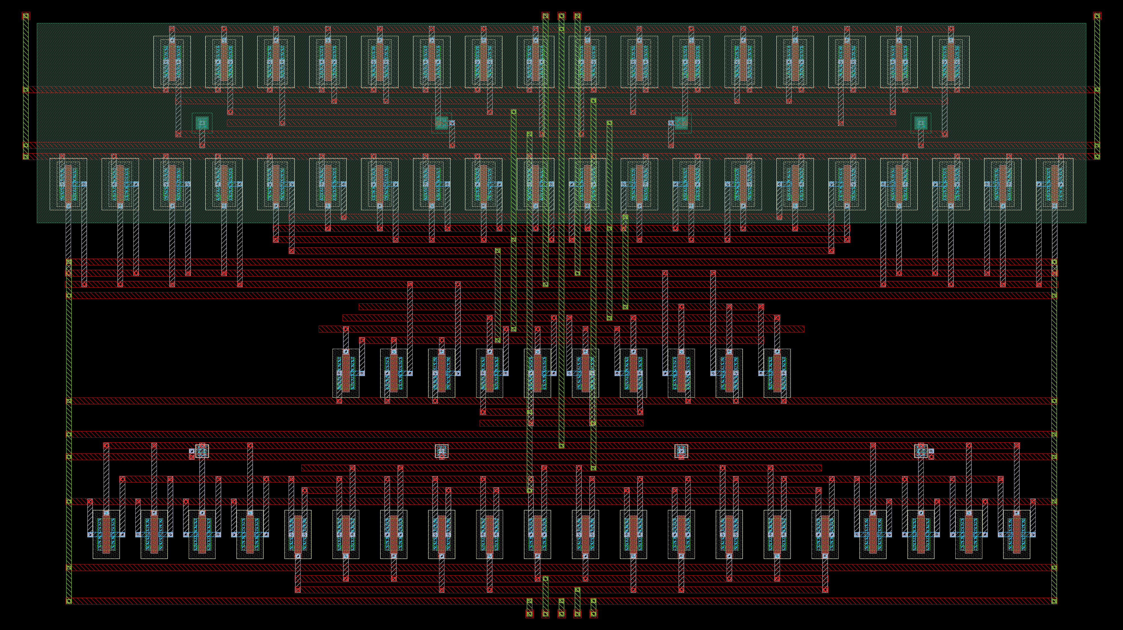
[picture p27: docs/layouts/strong_arm_comp.png]
Strong-arm comparator
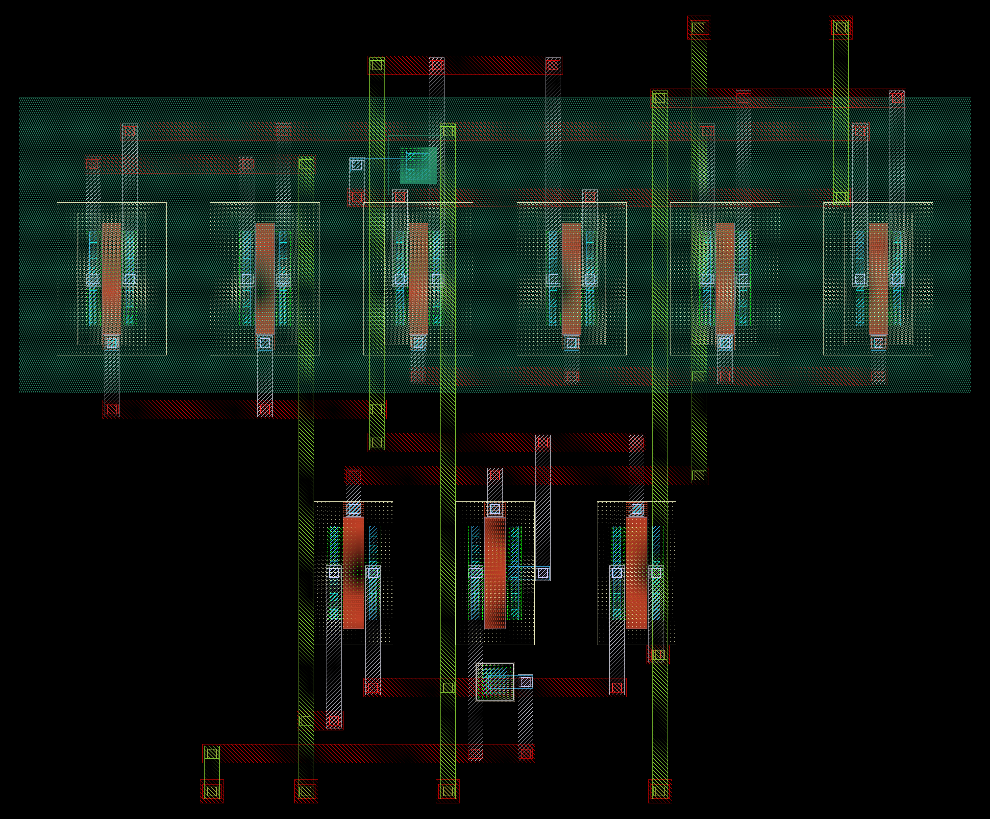
[picture p28: docs/layouts/dac_sw_2to1_tg.png]
DAC switch
| <br><sub>Strong-arm comparator</sub> | <br><sub>DAC switch</sub> |
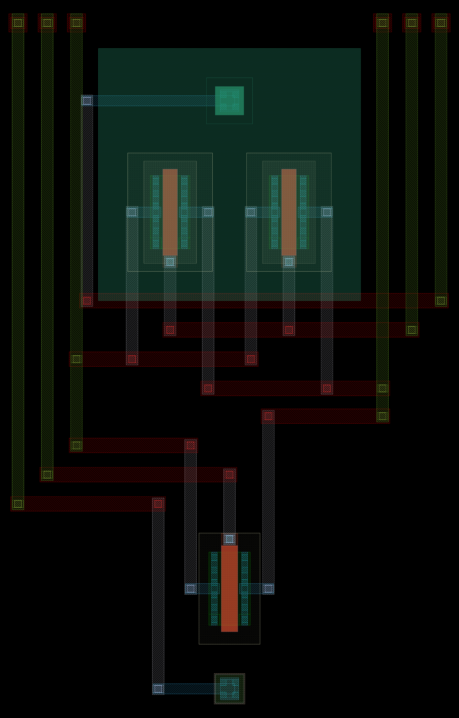
[picture p29: docs/layouts/tg.png]
Transmission gate
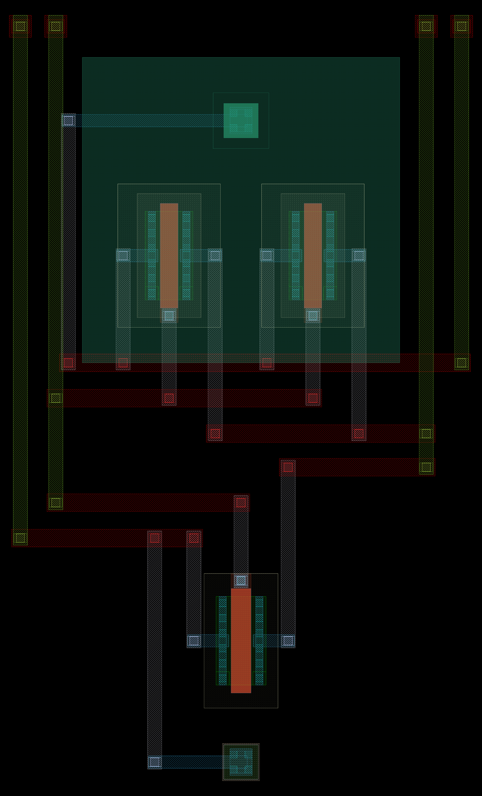
[picture p30: docs/layouts/inverter.png]
Inverter
| <br><sub>Transmission gate</sub> | <br><sub>Inverter</sub> |
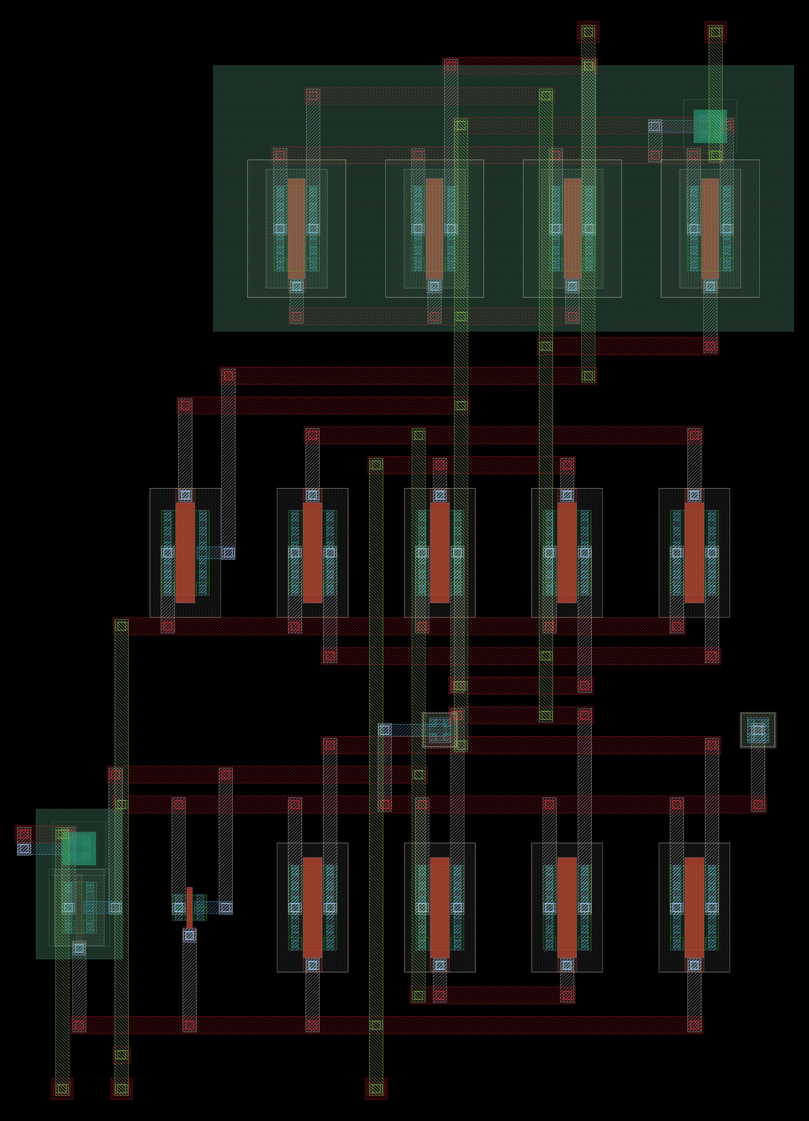
[picture p31: docs/layouts/level_shifter_1v2_to_3v3.png]
1.2 V to 3.3 V level shifter
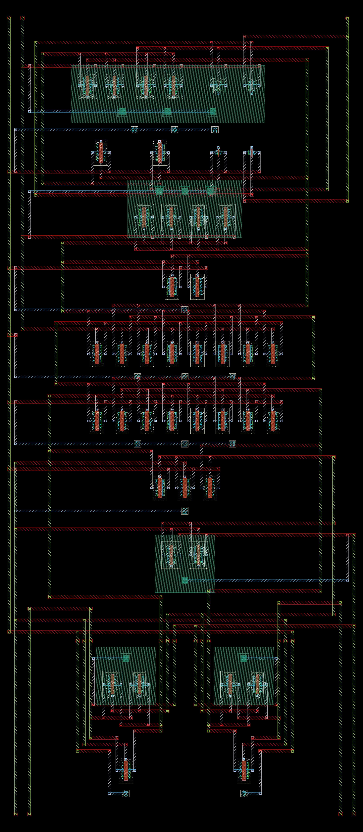
[picture p32: docs/layouts/level_shifter_3v3_to_1v2.png]
3.3 V to 1.2 V level shifter
| <br><sub>1.2 V to 3.3 V level shifter</sub> | <br><sub>3.3 V to 1.2 V level shifter</sub> |
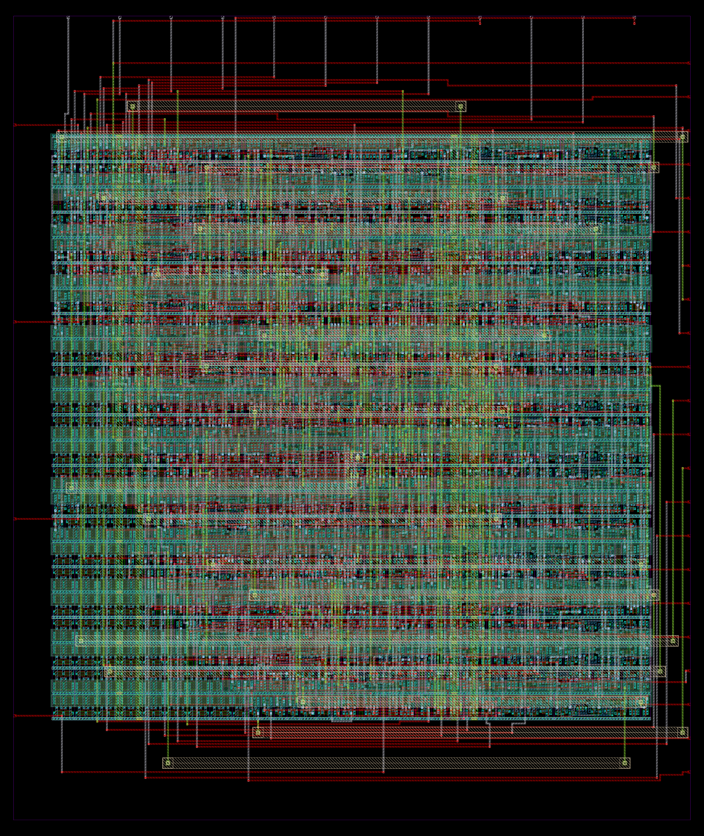
[picture p33: docs/layouts/sar_fsm_wrapper.png]
SAR FSM layout
| <br><sub>SAR FSM layout</sub> | |

## Schematics

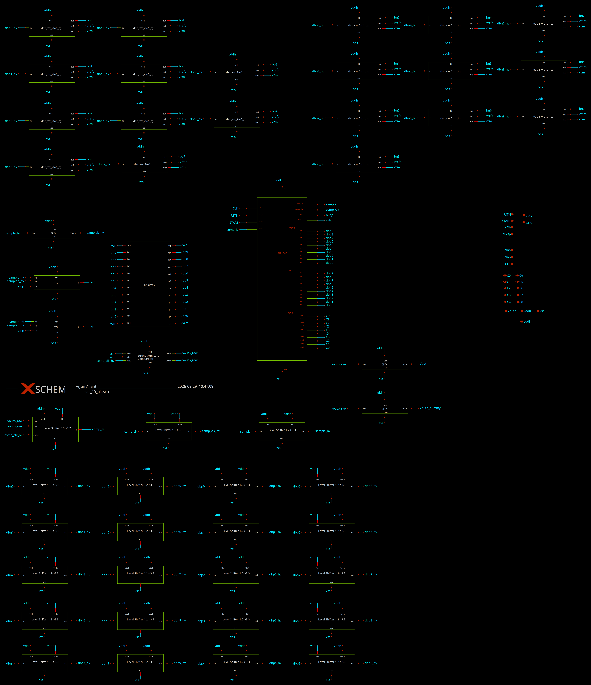
[picture p34: docs/schematics/01_TOP_sar_10_bit_adc.png]
Top-level SAR ADC schematic


*Top-level ADC schematic.*

| | |
|:---:|:---:|
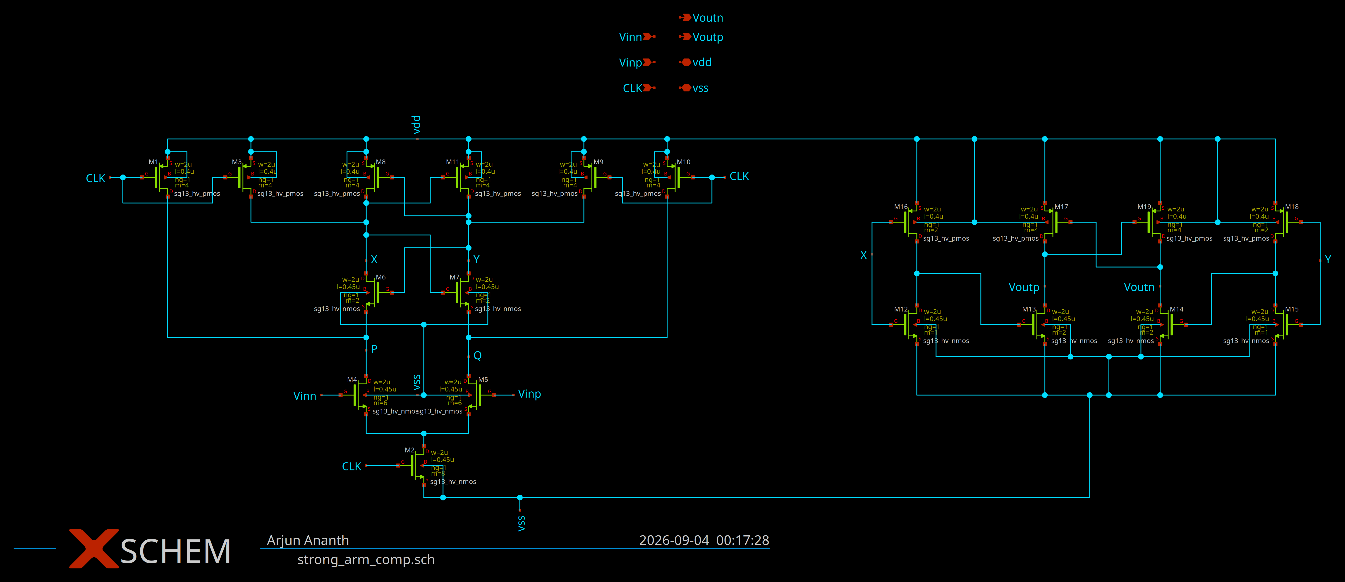
[picture p35: docs/schematics/02_strong_arm_comp.png]
Strong-arm comparator schematic
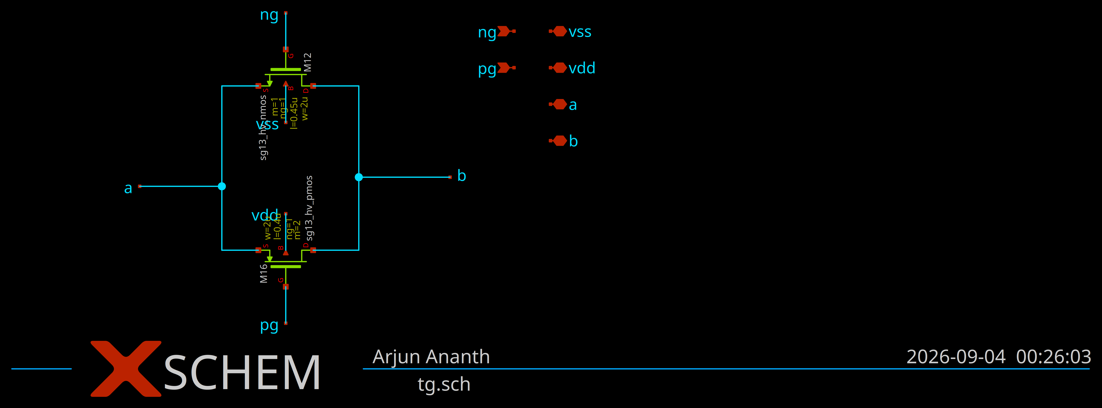
[picture p36: docs/schematics/03_tg.png]
Transmission gate schematic
| <br><sub>Strong-arm comparator schematic</sub> | <br><sub>Transmission gate schematic</sub> |
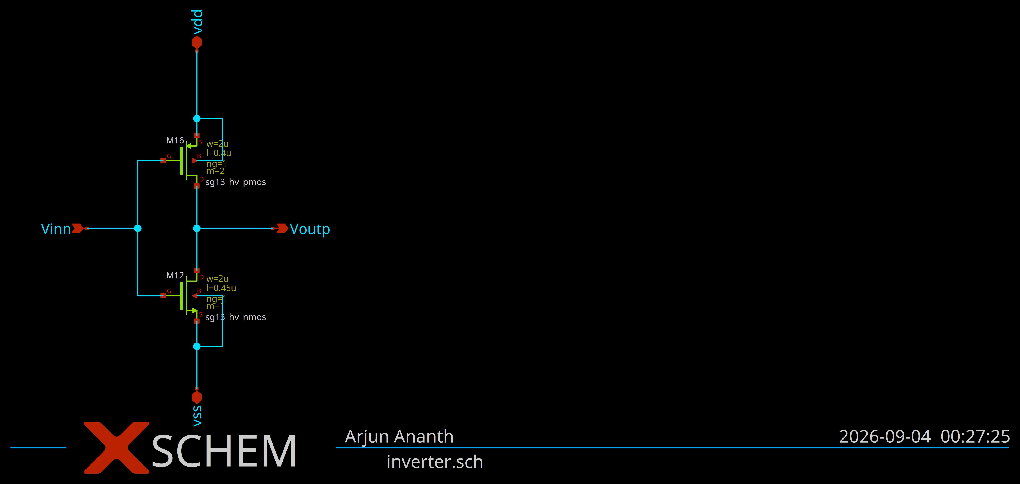
[picture p37: docs/schematics/04_inverter.png]
Inverter schematic
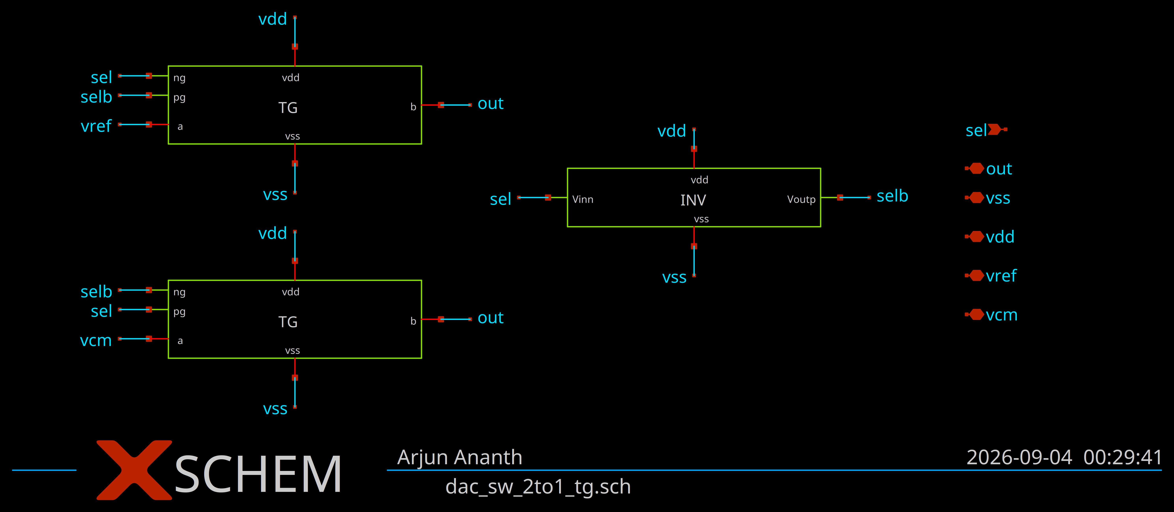
[picture p38: docs/schematics/05_dac_sw_2to1_tg.png]
DAC switch schematic
| <br><sub>Inverter schematic</sub> | <br><sub>DAC switch schematic</sub> |
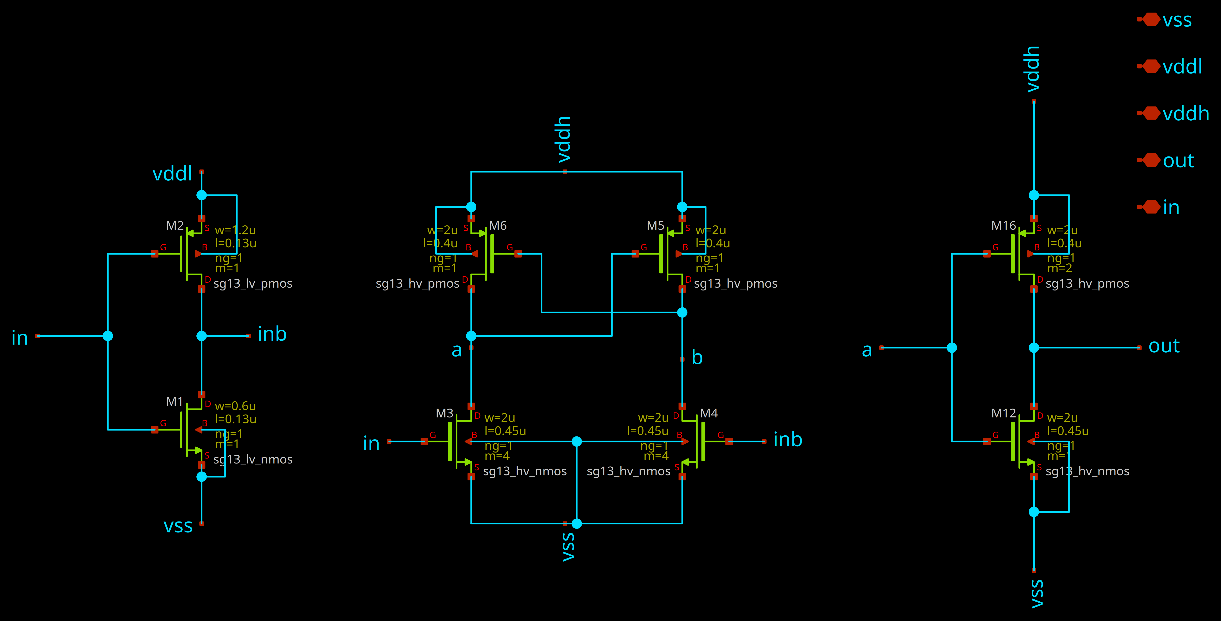
[picture p39: docs/schematics/06_level_shifter_1v2_to_3v3.png]
1.2 V to 3.3 V level shifter schematic
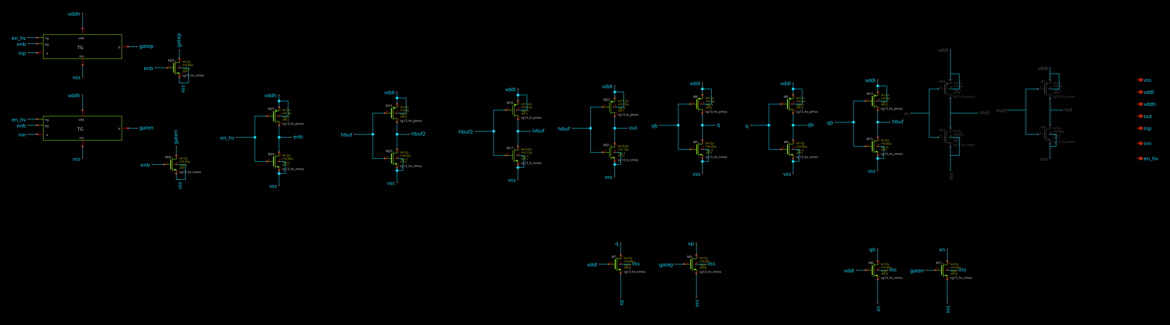
[picture p40: docs/schematics/07_level_shifter_3v3_to_1v2.png]
3.3 V to 1.2 V level shifter schematic
| <br><sub>1.2 V to 3.3 V level shifter schematic</sub> | <br><sub>3.3 V to 1.2 V level shifter schematic</sub> |
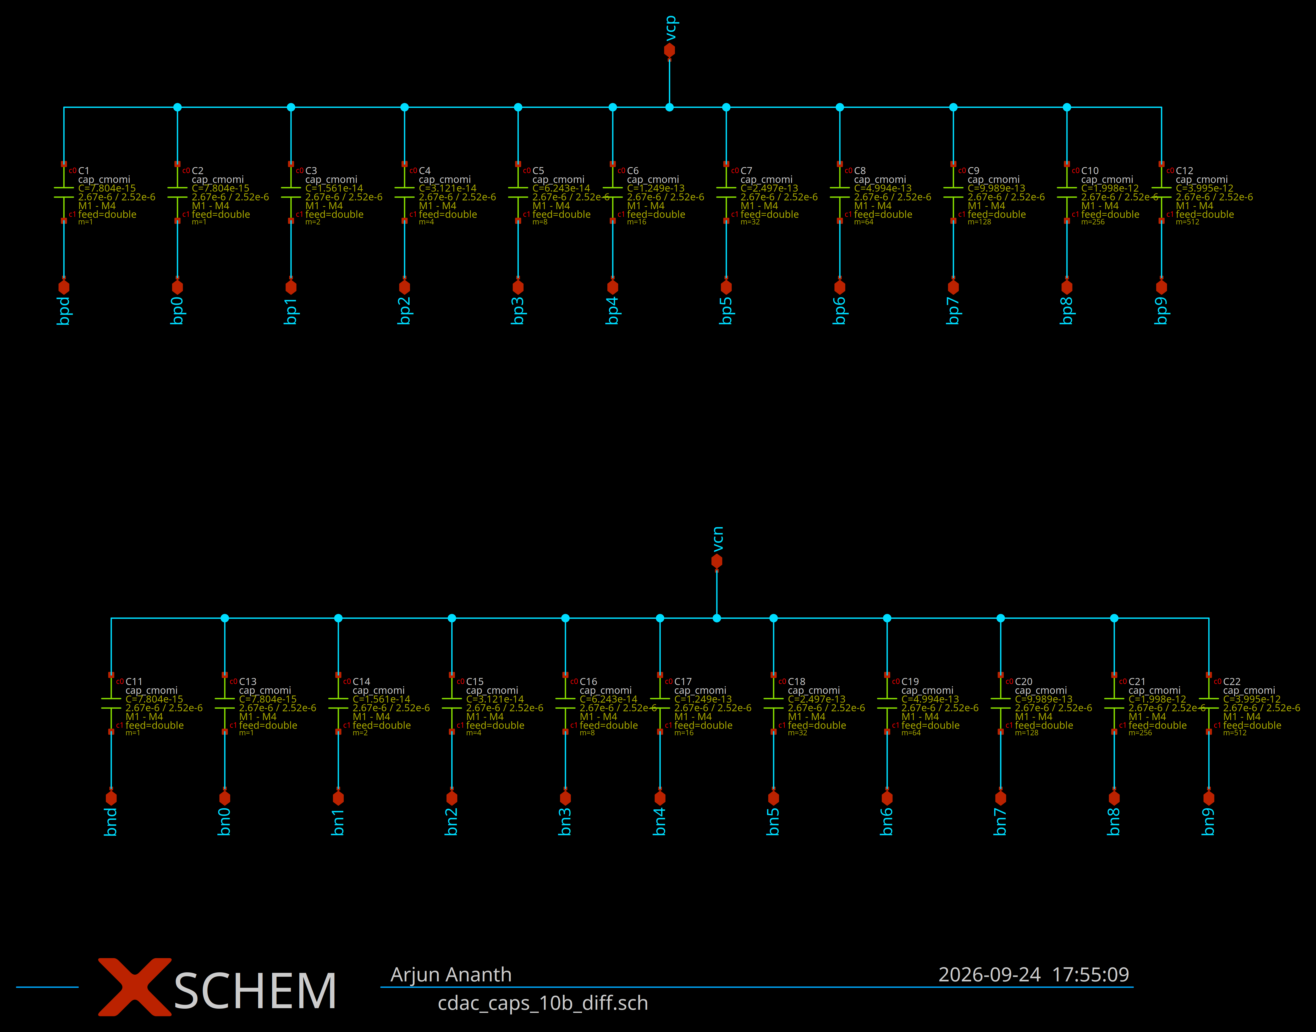
[picture p41: docs/schematics/08_cdac_caps_10b_diff.png]
Differential CDAC schematic
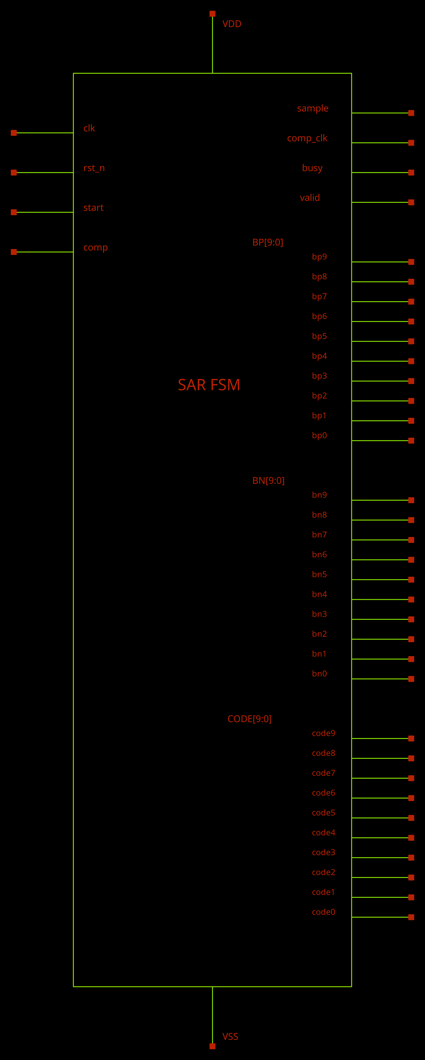
[picture p42: docs/schematics/09_sar_fsm_wrapper_symbol.png]
SAR FSM wrapper symbol
| <br><sub>Differential CDAC schematic</sub> | <br><sub>SAR FSM wrapper symbol</sub> |

---

# Repository Structure

```text
.
├── AUTHORS.md
│
├── circuit_files/
│   ├── layout/
│   │   ├── cdac/
│   │   ├── comparator/
│   │   ├── dac_switch/
│   │   ├── inverter/
│   │   ├── Levelshifter_1.2-3.3/
│   │   ├── Levelshifter_3.3-1.2/
│   │   ├── tg/
│   │   ├── top/
│   │   └── top_prefill/
│   │
│   ├── src/
│   │   └── sar_fsm/
│   │
│   ├── tb/
│   │
│   └── xschem/
│       ├── *.sch
│       ├── *.sym
│       ├── spice/
│       └── spice_pex/
│
├── chipalooza/
│   └── slot_16/
│       ├── layout/
│       ├── netlist/
│       └── verification/
│
├── final/
│   └── gds/
│       └── slot_16.gds
│
├── src/
│   ├── chip_core.sv
│   └── chip_top.sv
│
├── cocotb/
│   └── chip_top_tb.py
│
├── docs/
│   ├── Block_Diagram.png
│   ├── layouts/
│   ├── schematics/
│   ├── comparator/
│   ├── cdac_settling/
│   ├── corner/
│   ├── montecarlo/
│   ├── dnl_vs_code.png
│   ├── inl_vs_code.png
│   ├── sndr_enob_vs_fin.png
│   └── README.md
│
├── ip/
│   └── bondpad_70x70/
│
├── librelane/
│   ├── chip_top.sdc
│   └── config.yaml
│
├── Makefile
├── flake.nix
├── flake.lock
└── LICENSE
```

---

# Tools

The project uses the following open-source tools:

- Xschem
- ngspice
- KLayout
- Magic
- Yosys
- OpenROAD
- LibreLane
- Icarus Verilog
- cocotb

---

# Analog Simulation

Transistor-level testbenches are located under:

```text
circuit_files/tb/
```

Available testbenches include:

```text
cdac_caps_10b_diff_tb.sch
cdac_comp_msb_step_tb.sch
cdac_comp_sar_fsm_tb.sch
dac_sw_tb.sch
inv_tb.sch
LS_h2l_tb.sch
LS_l2h_tb.sch
sar_10_bit_tb.sch
sar_10_bit_tb_1.sch
strong_arm_comp_tb.sch
tg_tb.sch
```

Schematics and SPICE views are located under:

```text
circuit_files/xschem/
```

The directory also contains extracted/post-layout SPICE views under:

```text
circuit_files/xschem/spice_pex/
```

# Silicon Bring-Up Plan

Initial silicon testing is planned in the following order:

1. Verify continuity and supply connections.
2. Apply the 1.2 V and 3.3 V rails through the appropriate harness controls.
3. Hold the ADC in reset (`RSTN = 0`).
4. Measure static current.
5. Enable the project clock.
6. Apply the required `VCM` and `VREFP` through shared analog buses 1 and 0, respectively, with suitable external decoupling.
7. Apply a differential mid-scale input.
8. Release reset with START low, then trigger a conversion using the appropriate GPIO route or sequencer.
9. Check `busy`, `valid`, and `C[9:0]` through the harness readout.
10. Test several DC input levels.
11. Perform a complete DC transfer sweep.
12. Measure DNL, INL, offset, and gain.
13. Apply a sinusoidal differential input.
14. Measure SNR, SNDR, SFDR, and ENOB.
15. Repeat key measurements over voltage and temperature where practical.

---

## License

This project is licensed under the **Apache License 2.0**.

See [LICENSE](LICENSE) for details.
