arjun2000ananth/SAR_ADC_IHP/docs/README.md

# 10-Bit SAR ADC — IHP SG13CMOS5L

Block-level and ADC characterisation results, including parasitic extraction, process-corner sweeps, and statistical analysis. Test conditions are shown in the individual plots.

## Block Diagram

10-bit SAR ADC block diagram

## Individual Block Testbenches

### Transmission Gate

The input pulse switches between 0 V and 3.3 V every 30 ns. The transmission gate drives a 5.12 pF load.

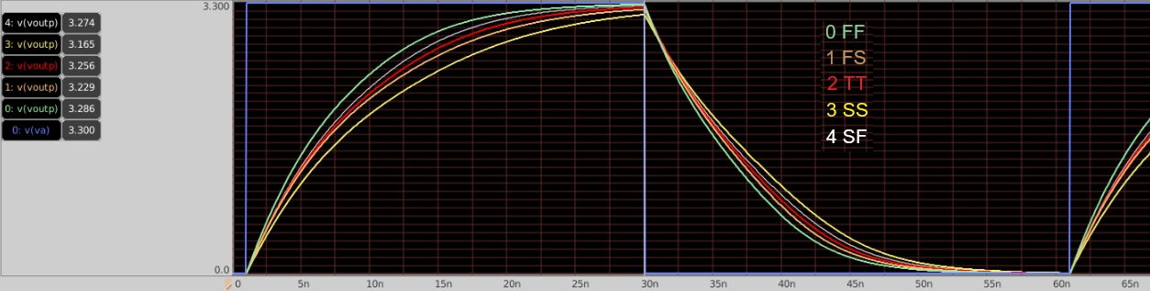
[picture p43: docs/tg.png]
Transmission gate waveform


### Comparator

The comparator inputs are 1.65 V ± 5 mV. Each output drives a 20 fF load.

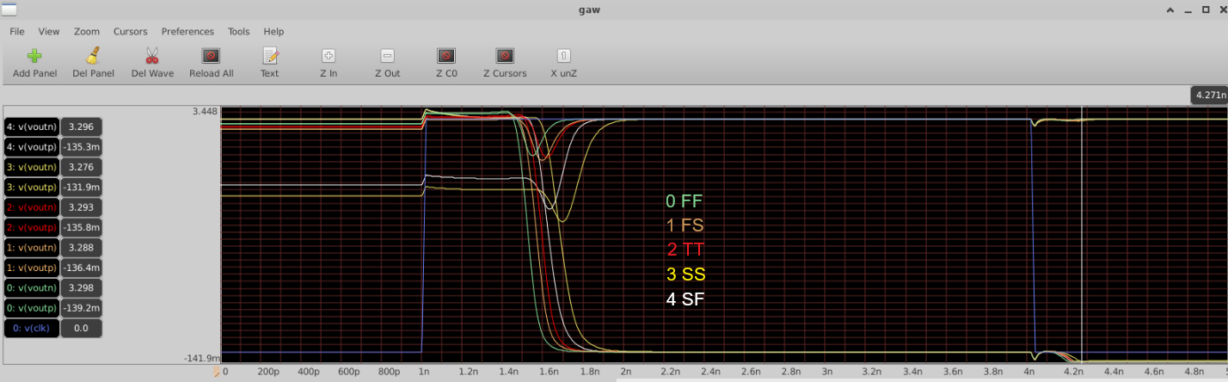
[picture p44: docs/comparator.png]
Comparator waveform


### DAC Switch

A selector signal determines whether the load capacitance is driven high or low. The load is 25.6 pF, equivalent to 5,120 unit capacitors of 5 fF each.

The upper waveform shows charging the load; the lower waveform shows discharging it.

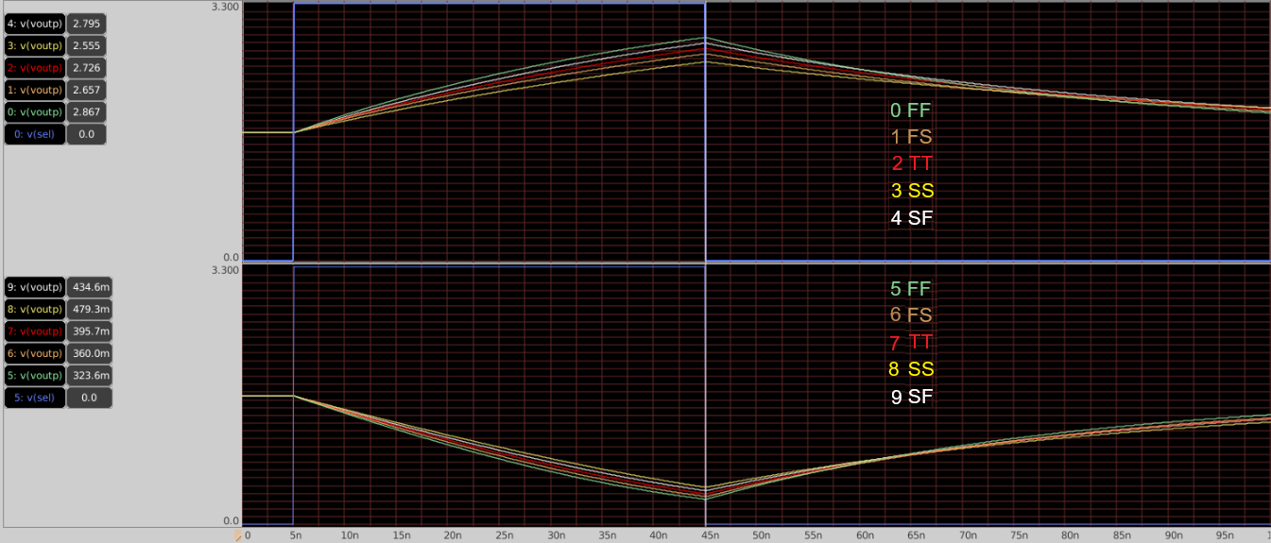
[picture p45: docs/dac_SW.png]
DAC switch waveform


## ADC Transfer Characteristic

### Full Input Range

ADC transfer characteristic

### Midscale Detail

ADC transfer characteristic near midscale

## Static Linearity

### Differential Nonlinearity

DNL versus output code

### Integral Nonlinearity

INL versus output code

### PEX Comparison

DNL and INL comparison

### Code-Width Distribution

Code-width histogram

## Dynamic Performance

SNDR and ENOB versus input frequency

## ADC Waveforms

### SAR Switching

SAR switching waveforms

### Common-Mode Test at VCM = 1.45 V

ADC smoke-test waveforms at VCM 1.45 V

## CDAC Switching and Settling

### Switching Waveforms

CDAC switching during SAR conversion

### MSB Settling Across PVT

MSB settling across process, voltage, and temperature

## Comparator Characterisation

### Decision Time Versus Input Overdrive

Comparator decision time versus input overdrive

### Decision Waveforms — SS, 125 °C, VDDH = 3.0 V

Comparator decision waveforms at SS, 125 degrees Celsius, and 3.0 V

### Input-Referred Noise

Comparator noise S-curve

### Offset and Decision-History Dependence

Comparator offset and decision-history dependence versus common-mode voltage

## Corner Analysis

PVT corner summary

## Monte Carlo Analysis

### Comparator Offset Distribution

Monte Carlo comparator offset histogram

### Statistical Linearity

Monte Carlo static-linearity results

### ENOB Distribution

Monte Carlo ENOB distribution

## Power Consumption

Power consumption at 50 MHz and 65 MHz
