arjun2000ananth/SAR_ADC_IHP/circuit_files/src/sar_fsm/build/physical/metrics.csv

Metric | Value
design__lint_error__count | 0
design__lint_timing_construct__count | 0
design__lint_warning__count | 4
design__inferred_latch__count | 0
design__instance__count | 756
design__instance__area | 9431.25
design__instance_unmapped__count | 0
synthesis__check_error__count | 0
design__max_slew_violation__count__corner:nom_fast_1p32V_m40C | 0
design__max_fanout_violation__count__corner:nom_fast_1p32V_m40C | 0
design__max_cap_violation__count__corner:nom_fast_1p32V_m40C | 0
power__internal__total | 0.00016596335626672953
power__switching__total | 0.000028394761102390476
power__leakage__total | 2.5068513309634E-7
power__total | 0.00019460880139376968
clock__skew__worst_hold__corner:nom_fast_1p32V_m40C | -0.2899147393101896
clock__skew__worst_setup__corner:nom_fast_1p32V_m40C | 0.2670975183295051
timing__hold__ws__corner:nom_fast_1p32V_m40C | 0.13359863593554444
timing__setup__ws__corner:nom_fast_1p32V_m40C | 14.442683902065449
timing__hold__tns__corner:nom_fast_1p32V_m40C | 0.0
timing__setup__tns__corner:nom_fast_1p32V_m40C | 0.0
timing__hold__wns__corner:nom_fast_1p32V_m40C | 0
timing__setup__wns__corner:nom_fast_1p32V_m40C | 0.0
timing__hold_vio__count__corner:nom_fast_1p32V_m40C | 0
timing__hold_r2r__ws__corner:nom_fast_1p32V_m40C | 0.133599
timing__hold_r2r_vio__count__corner:nom_fast_1p32V_m40C | 0
timing__setup_vio__count__corner:nom_fast_1p32V_m40C | 0
timing__setup_r2r__ws__corner:nom_fast_1p32V_m40C | 18.657951
timing__setup_r2r_vio__count__corner:nom_fast_1p32V_m40C | 0
design__max_slew_violation__count__corner:nom_slow_1p08V_125C | 0
design__max_fanout_violation__count__corner:nom_slow_1p08V_125C | 0
design__max_cap_violation__count__corner:nom_slow_1p08V_125C | 0
clock__skew__worst_hold__corner:nom_slow_1p08V_125C | -0.3306804645928218
clock__skew__worst_setup__corner:nom_slow_1p08V_125C | 0.27664993301469193
timing__hold__ws__corner:nom_slow_1p08V_125C | 0.6701388522669478
timing__setup__ws__corner:nom_slow_1p08V_125C | 12.616368751262184
timing__hold__tns__corner:nom_slow_1p08V_125C | 0.0
timing__setup__tns__corner:nom_slow_1p08V_125C | 0.0
timing__hold__wns__corner:nom_slow_1p08V_125C | 0
timing__setup__wns__corner:nom_slow_1p08V_125C | 0.0
timing__hold_vio__count__corner:nom_slow_1p08V_125C | 0
timing__hold_r2r__ws__corner:nom_slow_1p08V_125C | 0.670139
timing__hold_r2r_vio__count__corner:nom_slow_1p08V_125C | 0
timing__setup_vio__count__corner:nom_slow_1p08V_125C | 0
timing__setup_r2r__ws__corner:nom_slow_1p08V_125C | 17.112720
timing__setup_r2r_vio__count__corner:nom_slow_1p08V_125C | 0
design__max_slew_violation__count__corner:nom_typ_1p20V_25C | 0
design__max_fanout_violation__count__corner:nom_typ_1p20V_25C | 0
design__max_cap_violation__count__corner:nom_typ_1p20V_25C | 0
clock__skew__worst_hold__corner:nom_typ_1p20V_25C | -0.3052072014840574
clock__skew__worst_setup__corner:nom_typ_1p20V_25C | 0.27030617398372125
timing__hold__ws__corner:nom_typ_1p20V_25C | 0.32871717389612465
timing__setup__ws__corner:nom_typ_1p20V_25C | 13.794647592442445
timing__hold__tns__corner:nom_typ_1p20V_25C | 0.0
timing__setup__tns__corner:nom_typ_1p20V_25C | 0.0
timing__hold__wns__corner:nom_typ_1p20V_25C | 0
timing__setup__wns__corner:nom_typ_1p20V_25C | 0.0
timing__hold_vio__count__corner:nom_typ_1p20V_25C | 0
timing__hold_r2r__ws__corner:nom_typ_1p20V_25C | 0.328717
timing__hold_r2r_vio__count__corner:nom_typ_1p20V_25C | 0
timing__setup_vio__count__corner:nom_typ_1p20V_25C | 0
timing__setup_r2r__ws__corner:nom_typ_1p20V_25C | 18.105049
timing__setup_r2r_vio__count__corner:nom_typ_1p20V_25C | 0
design__max_slew_violation__count | 0
design__max_fanout_violation__count | 0
design__max_cap_violation__count | 0
clock__skew__worst_hold | -0.2899147393101896
clock__skew__worst_setup | 0.2670975183295051
timing__hold__ws | 0.13359863593554444
timing__setup__ws | 12.616368751262184
timing__hold__tns | 0.0
timing__setup__tns | 0.0
timing__hold__wns | 0
timing__setup__wns | 0.0
timing__hold_vio__count | 0
timing__hold_r2r__ws | 0.133599
timing__hold_r2r_vio__count | 0
timing__setup_vio__count | 0
timing__setup_r2r__ws | 17.112720
timing__setup_r2r_vio__count | 0
design__die__bbox | 0.0 0.0 120.0 120.0
design__core__bbox | 5.76 15.12 114.24 102.06
design__io | 40
design__die__area | 14400
design__core__area | 9431.25
design__instance__count__stdcell | 449
design__instance__area__stdcell | 6755.01
design__instance__count__macros | 0
design__instance__area__macros | 0
design__instance__count__padcells | 0
design__instance__area__padcells | 0
design__instance__count__cover | 0
design__instance__area__cover | 0
design__instance__utilization | 0.716237
design__instance__utilization__stdcell | 0.716237
design__rows | 23
design__rows:CoreSite | 23
design__sites | 5198
design__sites:CoreSite | 5198
design__instance__count__class:inverter | 31
design__instance__area__class:inverter | 168.739
design__instance__count__class:sequential_cell | 49
design__instance__area__class:sequential_cell | 2400.45
design__instance__count__class:multi_input_combinational_cell | 179
design__instance__area__class:multi_input_combinational_cell | 1701.91
flow__warnings__count | 1
flow__errors__count | 0
flow__warnings__type_count | 1
flow__warnings__count:ORD-0039 | 1
design__power_grid_violation__count__net:VSS | 0
design__power_grid_violation__count__net:VDD | 0
design__power_grid_violation__count | 0
timing__drv__floating__nets | 0
timing__drv__floating__pins | 0
design__instance__displacement__total | 3521.34
design__instance__displacement__mean | 7.842
design__instance__displacement__max | 81.72
route__wirelength__estimated | 11632.6
design__violations | 0
design__instance__count__class:timing_repair_buffer | 174
design__instance__area__class:timing_repair_buffer | 2233.53
design__instance__count__class:clock_buffer | 9
design__instance__area__class:clock_buffer | 212.285
design__instance__count__class:clock_inverter | 7
design__instance__area__class:clock_inverter | 38.1024
design__instance__count__setup_buffer | 0
design__instance__count__hold_buffer | 107
global_route__vias | 2809
global_route__wirelength | 18914
antenna__violating__nets | 0
antenna__violating__pins | 0
route__antenna_violation__count | 0
antenna_diodes_count | 0
route__net | 447
route__net__special | 2
route__drc_errors__iter:0 | 159
route__wirelength__iter:0 | 12609
route__drc_errors__iter:1 | 86
route__wirelength__iter:1 | 12546
route__drc_errors__iter:2 | 110
route__wirelength__iter:2 | 12521
route__drc_errors__iter:3 | 1
route__wirelength__iter:3 | 12478
route__drc_errors__iter:4 | 0
route__wirelength__iter:4 | 12475
route__drc_errors | 0
route__wirelength | 12475
route__vias | 2765
route__vias__singlecut | 2765
route__vias__multicut | 0
flow__warnings__count:DRT-0349 | 7
design__disconnected_pin__count | 0
design__critical_disconnected_pin__count | 0
route__wirelength__max | 263.71
design__instance__count__class:fill_cell | 307
design__instance__area__class:fill_cell | 2676.24
timing__unannotated_net__count__corner:nom_fast_1p32V_m40C | 7
timing__unannotated_net_filtered__count__corner:nom_fast_1p32V_m40C | 0
timing__unannotated_net__count__corner:nom_slow_1p08V_125C | 7
timing__unannotated_net_filtered__count__corner:nom_slow_1p08V_125C | 0
timing__unannotated_net__count__corner:nom_typ_1p20V_25C | 7
timing__unannotated_net_filtered__count__corner:nom_typ_1p20V_25C | 0
timing__unannotated_net__count | 7
timing__unannotated_net_filtered__count | 0
