arjun2000ananth/SAR_ADC_IHP/circuit_files/src/sar_fsm/build/physical/render/sar_fsm_wrapper.png

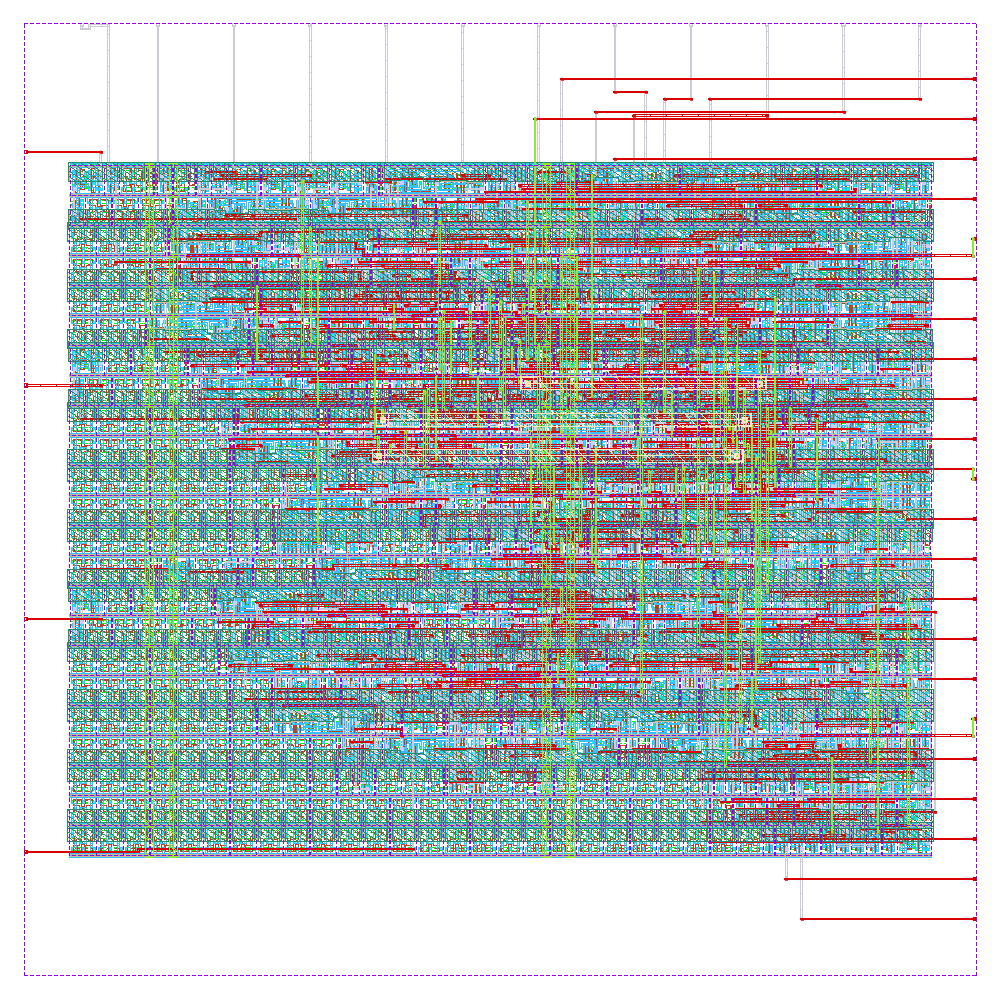
circuit_files/src/sar_fsm/build/physical/render/sar_fsm_wrapper.png
