arjun2000ananth/SAR_ADC_IHP/chipalooza/slot_16/verification/harness_cocotb/per_test_results.md

| # | Test | Icarus 12.0 | Icarus 13.0 | Sim time (ns, Icarus 13) |
|---|---|---|---|---|
| 1 | `test_analog.test_power_gate_reaches_only_selected_slot` | PASS | PASS | 31701 |
| 2 | `test_analog.test_power_gates_independent` | PASS | PASS | 41601 |
| 3 | `test_analog.test_deselecting_removes_power` | PASS | PASS | 21801 |
| 4 | `test_analog.test_power_is_off_after_reset` | PASS | PASS | 2101 |
| 5 | `test_analog.test_bias_switches_route_to_selected_slot` | PASS | PASS | 16801 |
| 6 | `test_analog.test_bias_switches_independent` | PASS | PASS | 36801 |
| 7 | `test_analog.test_vbias_follows_voltgen` | PASS | PASS | 86201 |
| 8 | `test_analog.test_voltgen_disabled_is_zero_not_floating` | PASS | PASS | 46201 |
| 9 | `test_analog.test_analog_bus_enables_are_one_hot` | PASS | PASS | 31701 |
| 10 | `test_analog.test_analog_bus_lines_independent` | PASS | PASS | 61401 |
| 11 | `test_analog.test_analog_bus_is_not_connected_to_any_slot_after_reset` | PASS | PASS | 2101 |
| 12 | `test_analog.test_project_zero_asserted_only_for_slot_zero` | PASS | PASS | 22001 |
| 13 | `test_analog.test_diagnostic_switches_drive_the_shared_pins` | PASS | PASS | 41501 |
| 14 | `test_analog.test_bandgap_off_is_zero_and_on_is_plausible` | PASS | PASS | 31601 |
| 15 | `test_analog.test_bandgap_trim_is_monotonic_and_saturates` | PASS | PASS | 121601 |
| 16 | `test_analog.test_pads_are_disconnected_by_default` | PASS | PASS | 7001 |
| 17 | `test_analog.test_pad_voltage_reaches_only_the_selected_slot` | PASS | PASS | 11901 |
| 18 | `test_analog.test_pad_is_gated_by_its_own_bus_enable` | PASS | PASS | 21801 |
| 19 | `test_analog.test_diagnostic_drive_takes_precedence_over_the_pad` | PASS | PASS | 36601 |
| 20 | `test_analog.test_bandgap_matches_the_characterised_curve` | PASS | PASS | 106601 |
| 21 | `test_analog.test_bandgap_nominal_is_half_trim` | PASS | PASS | 26601 |
| 22 | `test_bias.test_bias_defaults_produce_the_documented_currents` | PASS | PASS | 21701 |
| 23 | `test_bias.test_bias_range_checks_pass_with_the_documented_settings` | PASS | PASS | 31501 |
| 24 | `test_bias.test_bias_range_check_rejects_a_wrong_setting` | PASS | PASS | 36601 |
| 25 | `test_bias.test_biasgen_disabled_zeroes_every_bias` | PASS | PASS | 26701 |
| 26 | `test_bias.test_idac_outputs_scale_with_the_unit_current` | PASS | PASS | 71101 |
| 27 | `test_bias.test_idac_current_reaches_a_project_unclamped` | PASS | PASS | 46201 |
| 28 | `test_bias.test_bias_polarity_is_preserved_through_the_switches` | PASS | PASS | 41301 |
| 29 | `test_bias.test_bias_registers_read_back` | PASS | PASS | 41201 |
| 30 | `test_clocking.test_sram_clock_sources_are_exclusive` | PASS | PASS | 8721 |
| 31 | `test_clocking.test_sram_clock_follows_selected_source` | PASS | PASS | 3836 |
| 32 | `test_clocking.test_seq_strobe_is_not_a_clock` | PASS | PASS | 8721 |
| 33 | `test_clocking.test_loop_mode_tracks_command` | PASS | PASS | 7191 |
| 34 | `test_clocking.test_digital_reset_clears_sequencer` | PASS | PASS | 5531 |
| 35 | `test_no_clock.test_spi_and_register_file_without_a_clock` | PASS | PASS | 55901 |
| 36 | `test_no_clock.test_sram_access_without_a_clock` | PASS | PASS | 26201 |
| 37 | `test_no_clock.test_input_bus_constants_without_a_clock` | PASS | PASS | 127401 |
| 38 | `test_no_clock.test_input_bus_from_pads_without_a_clock` | PASS | PASS | 44901 |
| 39 | `test_no_clock.test_output_routing_without_a_clock` | PASS | PASS | 47201 |
| 40 | `test_no_clock.test_project_selection_and_enables_without_a_clock` | PASS | PASS | 16801 |
| 41 | `test_no_clock.test_analog_biases_settle_without_a_clock` | PASS | PASS | 26601 |
| 42 | `test_no_clock.test_sequencer_and_pattern_generator_are_frozen` | PASS | PASS | 62701 |
| 43 | `test_no_clock.test_constants_still_work_while_the_sequencer_is_started` | PASS | PASS | 87401 |
| 44 | `test_pattern.test_reset_defaults` | PASS | PASS | 66267 |
| 45 | `test_pattern.test_mode_clock_walks_memory` | PASS | PASS | 141188 |
| 46 | `test_pattern.test_mode_clock_data_lags_address_by_one` | PASS | PASS | 54616 |
| 47 | `test_pattern.test_mode_clock_loop_and_single_shot` | PASS | PASS | 97531 |
| 48 | `test_pattern.test_mode_strobe_steps_on_the_sequencer` | PASS | PASS | 55306 |
| 49 | `test_pattern.test_mode_timed_latches_the_timer_byte` | PASS | PASS | 65796 |
| 50 | `test_pattern.test_mode_timed_holds_each_pattern_for_its_interval` | PASS | PASS | 56138 |
| 51 | `test_pattern.test_mode_timed_timer_zero` | PASS | PASS | 55238 |
| 52 | `test_pattern.test_undefined_mode_is_inert` | PASS | PASS | 97448 |
| 53 | `test_project_control.test_select_is_one_hot` | PASS | PASS | 180201 |
| 54 | `test_project_control.test_slot_zero_selects_nothing` | PASS | PASS | 11901 |
| 55 | `test_project_control.test_addresses_above_18_select_nothing` | PASS | PASS | 31701 |
| 56 | `test_project_control.test_unselected_slots_see_no_enables` | PASS | PASS | 11901 |
| 57 | `test_project_control.test_dig_in_latch_is_transparent_then_holds` | FAIL | PASS | 110401 |
| 58 | `test_project_control.test_dig_in_latch_clears_when_deselected` | FAIL | PASS | 63501 |
| 59 | `test_project_control.test_only_the_selected_slot_sees_the_bus` | FAIL | PASS | 58501 |
| 60 | `test_project_control.test_proj_clk_runs_only_on_the_selected_slot` | FAIL | PASS | 11976 |
| 61 | `test_project_control.test_proj_clk_has_no_glitch_when_selection_changes` | FAIL | PASS | 12031 |
| 62 | `test_project_control.test_proj_clk_stops_cleanly_on_deselect` | FAIL | PASS | 16761 |
| 63 | `test_project_control.test_proj_reset_is_synchronised_and_per_slot` | PASS | PASS | 13721 |
| 64 | `test_project_control.test_dig_out_daisy_chain_is_continuous` | PASS | PASS | 11901 |
| 65 | `test_router.test_every_project_input_can_reach_every_pad` | PASS | PASS | 504801 |
| 66 | `test_router.test_input_routing_is_per_bit` | PASS | PASS | 44901 |
| 67 | `test_router.test_input_constant_codes` | PASS | PASS | 43901 |
| 68 | `test_router.test_input_special_code_splits_sequencer_and_sram` | PASS | PASS | 43901 |
| 69 | `test_router.test_every_project_output_can_reach_every_pad` | PASS | PASS | 3256501 |
| 70 | `test_router.test_output_value_follows_the_routed_project_bit` | PASS | PASS | 25801 |
| 71 | `test_router.test_unrouted_pads_stay_inputs` | PASS | PASS | 66401 |
| 72 | `test_router.test_lowest_numbered_output_wins_a_contested_pad` | PASS | PASS | 24801 |
| 73 | `test_router.test_an_output_reaches_exactly_the_one_pad_it_names` | PASS | PASS | 24701 |
| 74 | `test_router.test_reset_routing_defaults` | PASS | PASS | 12101 |
| 75 | `test_router.test_sram_monitor_overrides_routing` | PASS | PASS | 29501 |
| 76 | `test_router.test_sequencer_monitor_takes_all_twelve_pads` | PASS | PASS | 34501 |
| 77 | `test_sequencer.test_reset_defaults` | PASS | PASS | 21601 |
| 78 | `test_sequencer.test_constant_modes` | PASS | PASS | 67998 |
| 79 | `test_sequencer.test_binary_up_count` | PASS | PASS | 35086 |
| 80 | `test_sequencer.test_binary_down_count` | PASS | PASS | 35086 |
| 81 | `test_sequencer.test_gray_up_count` | PASS | PASS | 35108 |
| 82 | `test_sequencer.test_gray_down_count` | PASS | PASS | 35086 |
| 83 | `test_sequencer.test_lfsr_mode_is_pseudorandom_and_never_locks_up` | PASS | PASS | 35806 |
| 84 | `test_sequencer.test_single_shot_stops_and_loop_wraps` | PASS | PASS | 68366 |
| 85 | `test_sequencer.test_strobe_pulses_at_the_wrap` | PASS | PASS | 35176 |
| 86 | `test_sequencer.test_prescaler_divides_the_clock` | PASS | PASS | 102906 |
| 87 | `test_sequencer.test_stop_and_digital_reset_clear_the_output` | PASS | PASS | 40284 |
| 88 | `test_sequencer.test_undefined_mode_does_not_hang_or_strobe` | PASS | PASS | 67991 |
| 89 | `test_spi.test_identity_registers` | PASS | PASS | 21601 |
| 90 | `test_spi.test_mask_rev_passthrough` | PASS | PASS | 11801 |
| 91 | `test_spi.test_register_write_readback` | PASS | PASS | 80401 |
| 92 | `test_spi.test_address_autoincrement` | PASS | PASS | 21401 |
| 93 | `test_spi.test_csb_resets_spi` | PASS | PASS | 20001 |
| 94 | `test_spi.test_nop_command` | PASS | PASS | 16701 |
| 95 | `test_sram.test_sram_write_read` | PASS | PASS | 23001 |
| 96 | `test_sram.test_sram_autoincrement_across_256` | PASS | PASS | 35801 |
| 97 | `test_sram.test_sram_high_addresses_are_distinct` | PASS | PASS | 35901 |
| 98 | `test_sram.test_sram_walking_ones` | PASS | PASS | 69601 |
| 99 | `test_sram.test_sram_read_does_not_disturb` | PASS | PASS | 45601 |
| 100 | `test_sram.test_register_access_after_sram_access` | PASS | PASS | 21501 |
