arjun2000ananth/SAR_ADC_IHP/circuit_files/src/sar_fsm/build/sar_fsm_wrapper_ihp.spice

* ------------------------------------------------------
* IHP SG13CMOS5L mapped SAR FSM
* Generated from Yosys mapped JSON
* Standard cells require external library include
* ------------------------------------------------------

.subckt sar_fsm_wrapper clk rst_n start comp sample comp_clk busy valid bp9 bp8 bp7 bp6 bp5 bp4 bp3 bp2 bp1 bp0 bn9 bn8 bn7 bn6 bn5 bn4 bn3 bn2 bn1 bn0 code9 code8 code7 code6 code5 code4 code3 code2 code1 code0 VDD VSS

* $abc$3065$auto$blifparse.cc:386:parse_blif$3066
XU0 n41 n40 VDD VSS sg13cmos5l_inv_1
* $abc$3065$auto$blifparse.cc:386:parse_blif$3067
XU1 n43 n42 VDD VSS sg13cmos5l_inv_1
* $abc$3065$auto$blifparse.cc:386:parse_blif$3068
XU2 n45 n44 VDD VSS sg13cmos5l_inv_1
* $abc$3065$auto$blifparse.cc:386:parse_blif$3069
XU3 n47 n46 VDD VSS sg13cmos5l_inv_1
* $abc$3065$auto$blifparse.cc:386:parse_blif$3070
XU4 n49 n48 VDD VSS sg13cmos5l_inv_1
* $abc$3065$auto$blifparse.cc:386:parse_blif$3071
XU5 n51 n50 VDD VSS sg13cmos5l_inv_1
* $abc$3065$auto$blifparse.cc:386:parse_blif$3072
XU6 n53 n52 VDD VSS sg13cmos5l_inv_1
* $abc$3065$auto$blifparse.cc:386:parse_blif$3073
XU7 n54 bn0 VDD VSS sg13cmos5l_inv_1
* $abc$3065$auto$blifparse.cc:386:parse_blif$3074
XU8 n55 bn1 VDD VSS sg13cmos5l_inv_1
* $abc$3065$auto$blifparse.cc:386:parse_blif$3075
XU9 n56 bn2 VDD VSS sg13cmos5l_inv_1
* $abc$3065$auto$blifparse.cc:386:parse_blif$3076
XU10 n57 bn3 VDD VSS sg13cmos5l_inv_1
* $abc$3065$auto$blifparse.cc:386:parse_blif$3077
XU11 n58 bn4 VDD VSS sg13cmos5l_inv_1
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
* $auto$ff.cc:266:slice$823
XU256 valid clk n80 rst_n VDD VSS sg13cmos5l_dfrbpq_1
* $auto$ff.cc:266:slice$824
XU257 sample clk n264 rst_n VDD VSS sg13cmos5l_dfrbpq_1
* $auto$ff.cc:266:slice$825
XU258 comp_clk clk n82 rst_n VDD VSS sg13cmos5l_dfrbpq_1

.ends sar_fsm_wrapper
