arjun2000ananth/SAR_ADC_IHP/circuit_files/layout/comparator/strong_arm_comp.pex.spice

* PEX produced on Thu Oct  1 10:06:51 AM CEST 2026 using /foss/tools/sak/sak-pex.sh with m=3 and s=1 (extresist threshold=10000 mOhm, minres=1000 mOhm, mindelay=1 ps)
* NGSPICE file created from strong_arm_comp_pex.ext - technology: ihp-sg13cmos5l

.subckt strong_arm_comp_pex CLK Voutp Voutn vdd vss Vinp Vinn
X0 vdd CLK a_n3535_6714.t8 vdd sg13_hv_pmos ad=0.68p pd=4.68u as=0.68p ps=4.68u w=2u l=0.4u
X1 a_n5655_794# Vinp a_n2885_6714.t4 vss.t7 sg13_hv_nmos ad=0.68p pd=4.68u as=0.68p ps=4.68u w=2u l=0.45u
X2 vdd a_n4185_6714.t15 a_n3535_6714.t4 vdd sg13_hv_pmos ad=0.68p pd=4.68u as=0.68p ps=4.68u w=2u l=0.4u
X3 vdd a_n4185_6714.t14 a_n3535_6714.t5 vdd sg13_hv_pmos ad=0.68p pd=4.68u as=0.68p ps=4.68u w=2u l=0.4u
X4 vdd Voutn Voutp vdd sg13_hv_pmos ad=0.68p pd=4.68u as=0.68p ps=4.68u w=2u l=0.4u
X5 vss.t25 CLK a_n5655_794# vss.t27 sg13_hv_nmos ad=0.68p pd=4.68u as=0.68p ps=4.68u w=2u l=0.45u
X6 a_n4835_6714.t5 CLK vdd vdd sg13_hv_pmos ad=0.68p pd=4.68u as=0.68p ps=4.68u w=2u l=0.4u
X7 a_n3535_6714.t1 a_n4185_6714.t11 a_n2885_6714.t0 vss.t2 sg13_hv_nmos ad=0.68p pd=4.68u as=0.68p ps=4.68u w=2u l=0.45u
X8 vss.t25 CLK a_n5655_794# vss.t26 sg13_hv_nmos ad=0.68p pd=4.68u as=0.68p ps=4.68u w=2u l=0.45u
X9 vdd CLK a_n2885_6714.t7 vdd sg13_hv_pmos ad=0.68p pd=4.68u as=0.68p ps=4.68u w=2u l=0.4u
X10 Voutp a_n3535_5182# vss.t1 vss.t5 sg13_hv_nmos ad=0.68p pd=4.68u as=0.68p ps=4.68u w=2u l=0.45u
X11 Voutn Voutp vdd vdd sg13_hv_pmos ad=0.68p pd=4.68u as=0.68p ps=4.68u w=2u l=0.4u
X12 vss.t25 CLK a_n5655_794# vss.t24 sg13_hv_nmos ad=0.68p pd=4.68u as=0.68p ps=4.68u w=2u l=0.45u
X13 vdd CLK a_n4835_6714.t7 vdd sg13_hv_pmos ad=0.68p pd=4.68u as=0.68p ps=4.68u w=2u l=0.4u
X14 vdd CLK a_n2885_6714.t8 vdd sg13_hv_pmos ad=0.68p pd=4.68u as=0.68p ps=4.68u w=2u l=0.4u
X15 vdd a_n3535_6714.t14 a_n4185_6714.t5 vdd sg13_hv_pmos ad=0.68p pd=4.68u as=0.68p ps=4.68u w=2u l=0.4u
X16 a_n2885_6714.t2 Vinp a_n5655_794# vss.t2 sg13_hv_nmos ad=0.68p pd=4.68u as=0.68p ps=4.68u w=2u l=0.45u
X17 vdd a_n3535_6714.t15 a_n4185_6714.t4 vdd sg13_hv_pmos ad=0.68p pd=4.68u as=0.68p ps=4.68u w=2u l=0.4u
X18 vdd a_n3535_6714.t13 a_n2885_5182# vdd sg13_hv_pmos ad=0.68p pd=4.68u as=0.68p ps=4.68u w=2u l=0.4u
X19 Voutp a_n3535_5182# vss.t17 vss.t11 sg13_hv_nmos ad=0.68p pd=4.68u as=0.68p ps=4.68u w=2u l=0.45u
X20 a_n4185_6714.t6 CLK vdd vdd sg13_hv_pmos ad=0.68p pd=4.68u as=0.68p ps=4.68u w=2u l=0.4u
X21 vss.t29 CLK a_n5655_794# vss.t28 sg13_hv_nmos ad=0.68p pd=4.68u as=0.68p ps=4.68u w=2u l=0.45u
X22 vdd CLK a_n3535_6714.t9 vdd sg13_hv_pmos ad=0.68p pd=4.68u as=0.68p ps=4.68u w=2u l=0.4u
X23 Voutp Voutn vdd vdd sg13_hv_pmos ad=0.68p pd=4.68u as=0.68p ps=4.68u w=2u l=0.4u
X24 a_n5655_794# Vinp a_n2885_6714.t2 vss.t3 sg13_hv_nmos ad=0.68p pd=4.68u as=0.68p ps=4.68u w=2u l=0.45u
X25 vdd a_n4185_6714.t13 a_n3535_5182# vdd sg13_hv_pmos ad=0.68p pd=4.68u as=0.68p ps=4.68u w=2u l=0.4u
X26 vss.t9 a_n3535_6714.t10 a_n2885_5182# vss.t7 sg13_hv_nmos ad=0.68p pd=4.68u as=0.68p ps=4.68u w=2u l=0.45u
X27 a_n4835_6714.t0 Vinn a_n5655_794# vss.t8 sg13_hv_nmos ad=0.68p pd=4.68u as=0.68p ps=4.68u w=2u l=0.45u
X28 a_n4835_6714.t4 a_n3535_6714.t11 a_n4185_6714.t1 vss.t4 sg13_hv_nmos ad=0.68p pd=4.68u as=0.68p ps=4.68u w=2u l=0.45u
X29 a_n2885_6714.t2 Vinp a_n5655_794# vss.t5 sg13_hv_nmos ad=0.68p pd=4.68u as=0.68p ps=4.68u w=2u l=0.45u
X30 vdd CLK a_n4835_6714.t8 vdd sg13_hv_pmos ad=0.68p pd=4.68u as=0.68p ps=4.68u w=2u l=0.4u
X31 Voutn Voutp vdd vdd sg13_hv_pmos ad=0.68p pd=4.68u as=0.68p ps=4.68u w=2u l=0.4u
X32 a_n4835_6714.t0 Vinn a_n5655_794# vss.t11 sg13_hv_nmos ad=0.68p pd=4.68u as=0.68p ps=4.68u w=2u l=0.45u
X33 a_n5655_794# Vinn a_n4835_6714.t1 vss.t4 sg13_hv_nmos ad=0.68p pd=4.68u as=0.68p ps=4.68u w=2u l=0.45u
X34 a_n4185_6714.t7 CLK vdd vdd sg13_hv_pmos ad=0.68p pd=4.68u as=0.68p ps=4.68u w=2u l=0.4u
X35 vdd Voutp Voutn vdd sg13_hv_pmos ad=0.68p pd=4.68u as=0.68p ps=4.68u w=2u l=0.4u
X36 a_n3535_6714.t7 CLK vdd vdd sg13_hv_pmos ad=0.68p pd=4.68u as=0.68p ps=4.68u w=2u l=0.4u
X37 a_n3535_6714.t0 a_n4185_6714.t16 vdd vdd sg13_hv_pmos ad=0.68p pd=4.68u as=0.68p ps=4.68u w=2u l=0.4u
X38 a_n4835_6714.t0 Vinn a_n5655_794# vss.t10 sg13_hv_nmos ad=0.68p pd=4.68u as=0.68p ps=4.68u w=2u l=0.45u
X39 Voutp Voutn vdd vdd sg13_hv_pmos ad=0.68p pd=4.68u as=0.68p ps=4.68u w=2u l=0.4u
X40 a_n3535_6714.t3 a_n4185_6714.t17 vdd vdd sg13_hv_pmos ad=0.68p pd=4.68u as=0.68p ps=4.68u w=2u l=0.4u
X41 a_n3535_5182# a_n4185_6714.t12 vss.t1 vss.t0 sg13_hv_nmos ad=0.68p pd=4.68u as=0.68p ps=4.68u w=2u l=0.45u
X42 a_n4185_6714.t0 a_n3535_6714.t12 a_n4835_6714.t3 vss.t8 sg13_hv_nmos ad=0.68p pd=4.68u as=0.68p ps=4.68u w=2u l=0.45u
X43 a_n4835_6714.t6 CLK vdd vdd sg13_hv_pmos ad=0.68p pd=4.68u as=0.68p ps=4.68u w=2u l=0.4u
X44 vdd CLK a_n4185_6714.t9 vdd sg13_hv_pmos ad=0.68p pd=4.68u as=0.68p ps=4.68u w=2u l=0.4u
X45 a_n2885_6714.t2 Vinp a_n5655_794# vss.t0 sg13_hv_nmos ad=0.68p pd=4.68u as=0.68p ps=4.68u w=2u l=0.45u
X46 a_n2885_6714.t6 CLK vdd vdd sg13_hv_pmos ad=0.68p pd=4.68u as=0.68p ps=4.68u w=2u l=0.4u
X47 a_n4185_6714.t3 a_n3535_6714.t16 vdd vdd sg13_hv_pmos ad=0.68p pd=4.68u as=0.68p ps=4.68u w=2u l=0.4u
X48 vdd Voutn Voutp vdd sg13_hv_pmos ad=0.68p pd=4.68u as=0.68p ps=4.68u w=2u l=0.4u
X49 a_n5655_794# CLK vss.t19 vss.t20 sg13_hv_nmos ad=0.68p pd=4.68u as=0.68p ps=4.68u w=2u l=0.45u
X50 a_n2885_6714.t5 CLK vdd vdd sg13_hv_pmos ad=0.68p pd=4.68u as=0.68p ps=4.68u w=2u l=0.4u
X51 a_n4185_6714.t2 a_n3535_6714.t17 vdd vdd sg13_hv_pmos ad=0.68p pd=4.68u as=0.68p ps=4.68u w=2u l=0.4u
X52 a_n5655_794# CLK vss.t19 vss.t21 sg13_hv_nmos ad=0.68p pd=4.68u as=0.68p ps=4.68u w=2u l=0.45u
X53 a_n5655_794# Vinp a_n2885_6714.t3 vss.t6 sg13_hv_nmos ad=0.68p pd=4.68u as=0.68p ps=4.68u w=2u l=0.45u
X54 vss.t14 a_n2885_5182# Voutn vss.t6 sg13_hv_nmos ad=0.68p pd=4.68u as=0.68p ps=4.68u w=2u l=0.45u
X55 a_n2885_5182# a_n3535_6714.t18 vdd vdd sg13_hv_pmos ad=0.68p pd=4.68u as=0.68p ps=4.68u w=2u l=0.4u
X56 a_n5655_794# CLK vss.t23 vss.t22 sg13_hv_nmos ad=0.68p pd=4.68u as=0.68p ps=4.68u w=2u l=0.45u
X57 a_n5655_794# Vinn a_n4835_6714.t1 vss.t12 sg13_hv_nmos ad=0.68p pd=4.68u as=0.68p ps=4.68u w=2u l=0.45u
X58 a_n2885_6714.t1 a_n4185_6714.t10 a_n3535_6714.t2 vss.t3 sg13_hv_nmos ad=0.68p pd=4.68u as=0.68p ps=4.68u w=2u l=0.45u
X59 a_n3535_6714.t6 CLK vdd vdd sg13_hv_pmos ad=0.68p pd=4.68u as=0.68p ps=4.68u w=2u l=0.4u
X60 vdd Voutp Voutn vdd sg13_hv_pmos ad=0.68p pd=4.68u as=0.68p ps=4.68u w=2u l=0.4u
X61 vss.t14 a_n2885_5182# Voutn vss.t12 sg13_hv_nmos ad=0.68p pd=4.68u as=0.68p ps=4.68u w=2u l=0.45u
X62 a_n5655_794# CLK vss.t19 vss.t18 sg13_hv_nmos ad=0.68p pd=4.68u as=0.68p ps=4.68u w=2u l=0.45u
X63 a_n5655_794# Vinn a_n4835_6714.t2 vss.t13 sg13_hv_nmos ad=0.68p pd=4.68u as=0.68p ps=4.68u w=2u l=0.45u
X64 vdd CLK a_n4185_6714.t8 vdd sg13_hv_pmos ad=0.68p pd=4.68u as=0.68p ps=4.68u w=2u l=0.4u
X65 a_n3535_5182# a_n4185_6714.t18 vdd vdd sg13_hv_pmos ad=0.68p pd=4.68u as=0.68p ps=4.68u w=2u l=0.4u
R0 vss.t28 vss.t18 363767
R1 vss.t18 vss.t20 363.784
R2 vss.t22 vss.t10 363.784
R3 vss.t10 vss.t0 363.784
R4 vss.t0 vss.t5 363.784
R5 vss.t8 vss.t2 363.784
R6 vss.t2 vss.t3 363.784
R7 vss.t3 vss.t4 363.784
R8 vss.t6 vss.t7 363.784
R9 vss.t7 vss.t13 363.784
R10 vss.t13 vss.t24 363.784
R11 vss.t27 vss.t28 363.784
R12 vss.t20 vss.n18 343.17
R13 vss.n16 vss.t22 343.17
R14 vss.t5 vss.n15 343.17
R15 vss.n13 vss.t8 343.17
R16 vss.t4 vss.n12 343.17
R17 vss.n10 vss.t6 343.17
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
C83 a_n2885_6714.t1 vss 1.18646f
C84 a_n2885_6714.n3 vss 2.779f
C85 a_n2885_6714.n4 vss 3.21721f
C86 a_n2885_6714.t2 vss 9.8126f
C87 a_n2885_6714.t3 vss 3.82591f
C88 a_n2885_6714.t4 vss 5.34445f
C89 vss.t9 vss 0.50052f
C90 vss.t14 vss 3.80434f
C91 vss.t1 vss 4.85344f
.ends
