arjun2000ananth/SAR_ADC_IHP/(commit log)

2026-09-27 SAR ADC current implementation
    [LS_h2l_tb.sch, LS_l2h_tb.sch, cdac_caps_10b_diff.sch, cdac_caps_10b_diff_ideal.sch, cdac_caps_10b_diff_tb.sch, cdac_comp_msb_step_tb.sch, cdac_comp_sar_fsm_tb.sch, dac_sw_2to1_tg.sch]
2026-09-30 Added final top layout of SAR ADC
2026-09-30 Added pex netlist of top
    [LS_h2l_tb.sch, LS_l2h_tb.sch, op-amp.sch, op-amp_diff.sch, op-amp_diff_looptest.sch, op-amp_tb.sch, ota_diff_tb.sch, untitled-1.sch]
2026-10-01 Integrate SAR ADC into Chipalooza slot 16
2026-10-02 Added PEX TB for DAC SW, comparator, TG, and L2H LS
    [LS_l2h_tb_pex.sch, dac_sw_tb_pex.sch, strong_arm_comp_tb_pex.sch, tg_tb_pex.sch]
